Marcobedendo78/Robot-Arduino-4.0/README_PCB.md

# Robot Arduino 4.0 – PCB Personalizzato

Questo progetto include un PCB personalizzato progettato per rendere l’installazione dei moduli, sensori e connessioni più ordinata ed efficiente per un robot tagliaerba basato su Arduino Mega e NodeMCU8266.

---

## 📦 Componenti da assemblare

Componenti


---

## 🧩 Dettaglio PCB principale

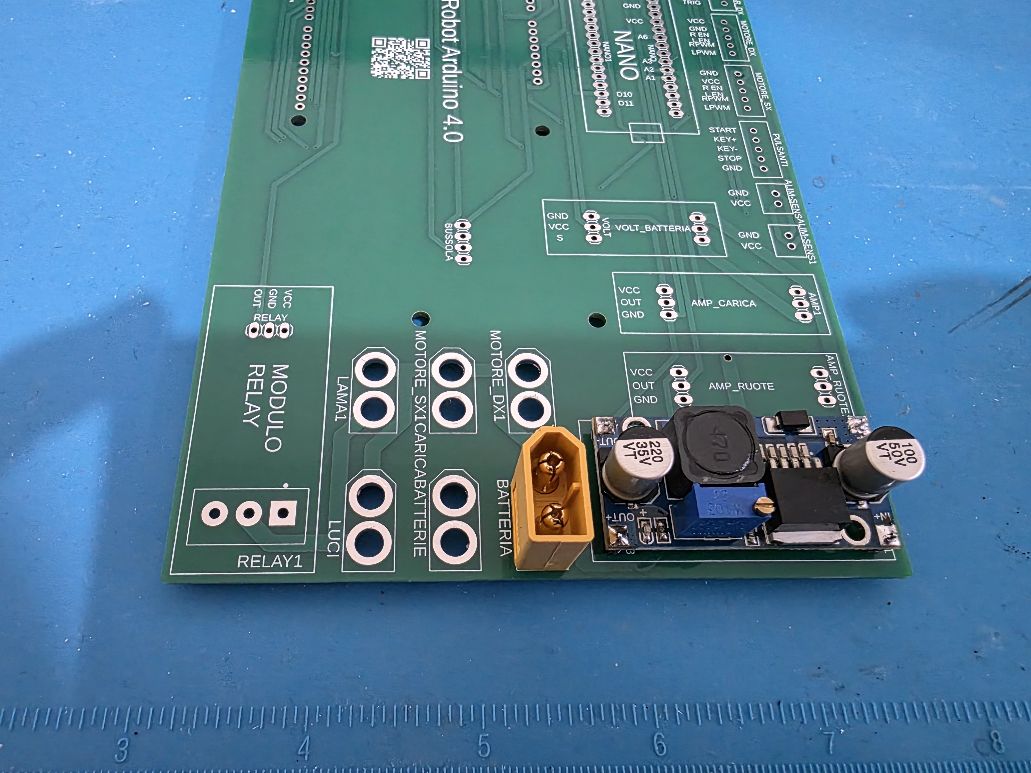
[picture p20: Img/20250508_175606.jpg]
PCB parziale

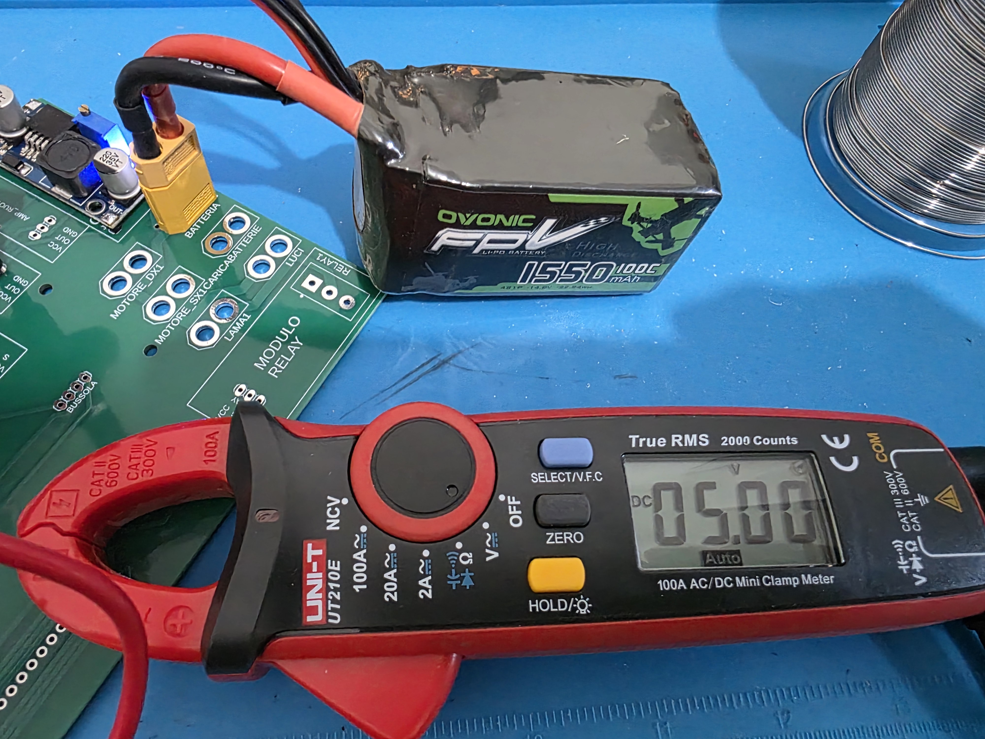
[picture p21: Img/20250508_175658.jpg]
Misurazione 5V


---

## 🔧 PCB Assemblato

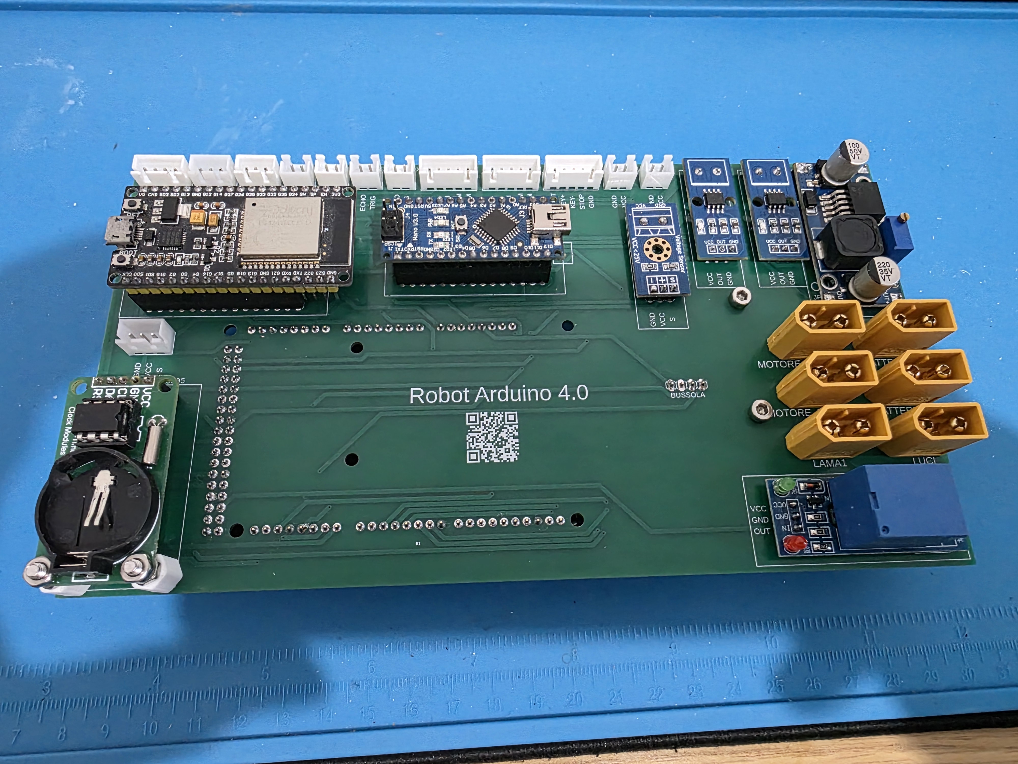
[picture p22: Img/20250508_194420.jpg]
PCB completo

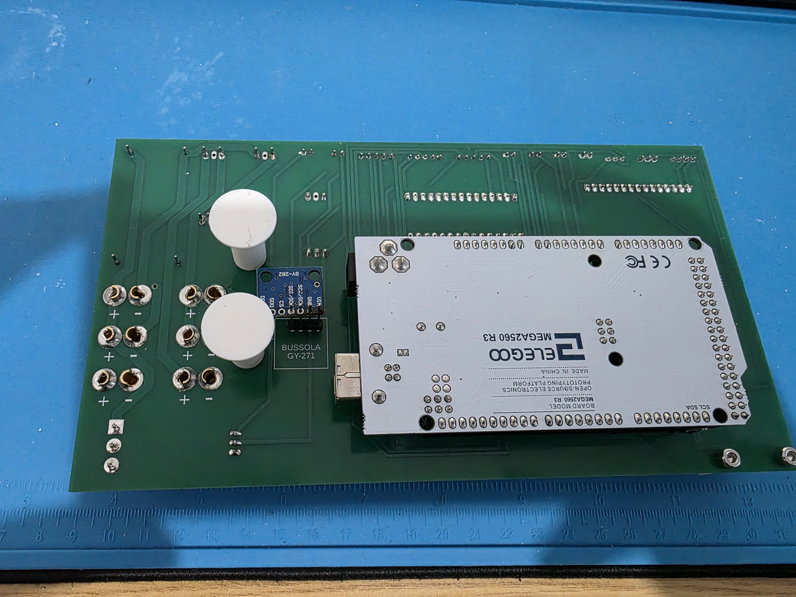
[picture p23: Img/20250508_194433.jpg]
Retro PCB


---

## 🧠 Dettaglio moduli installati

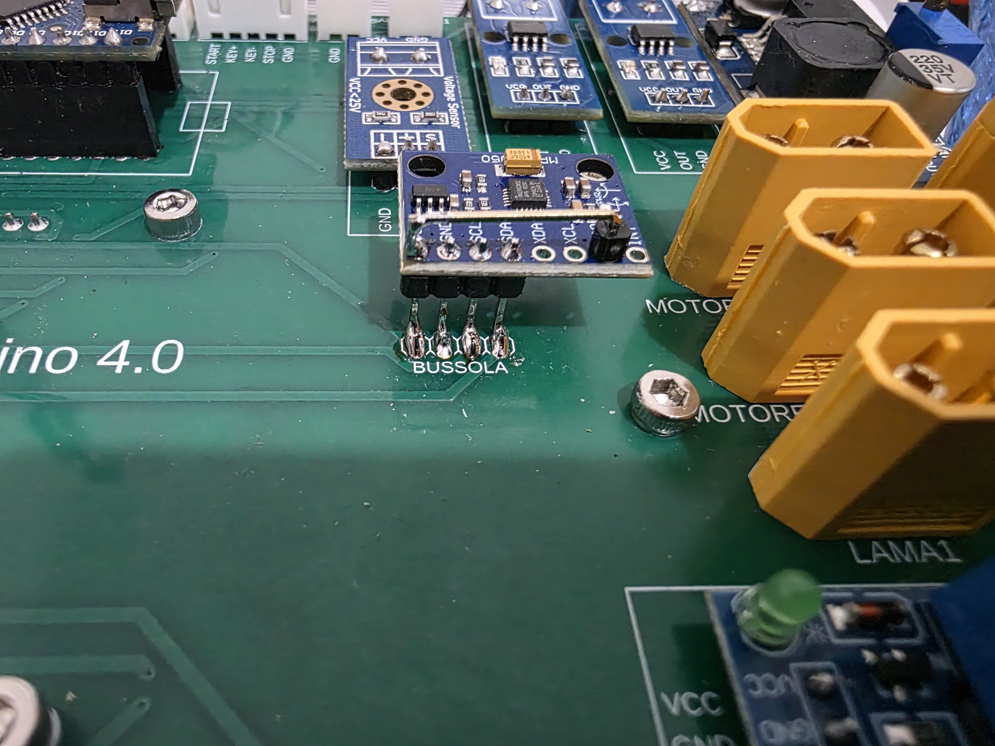
[picture p24: Img/20250530_201129.jpg]
Moduli montati

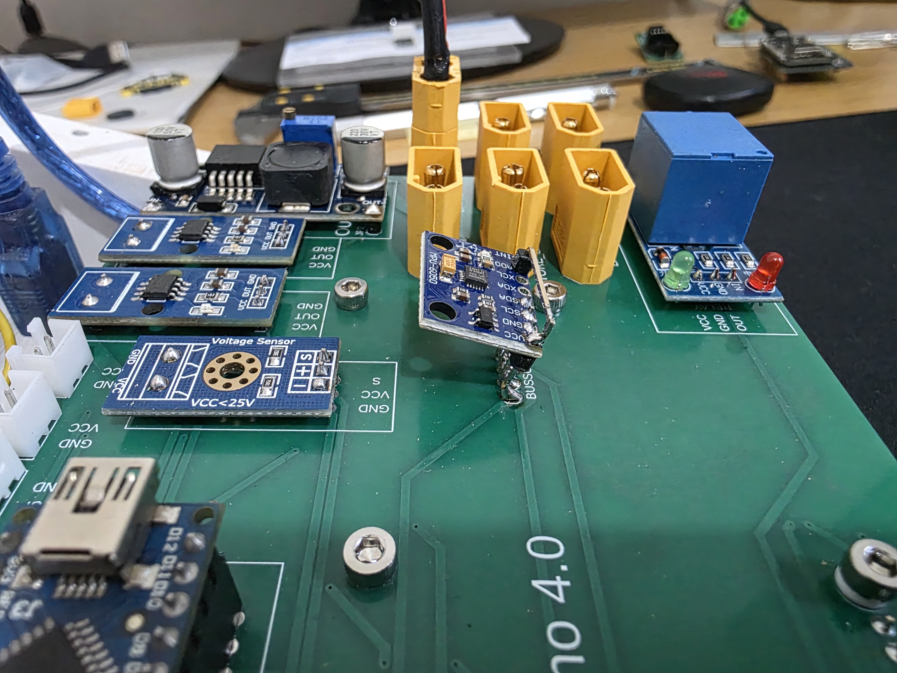
[picture p25: Img/20250531_141824.jpg]
Zoom bussola

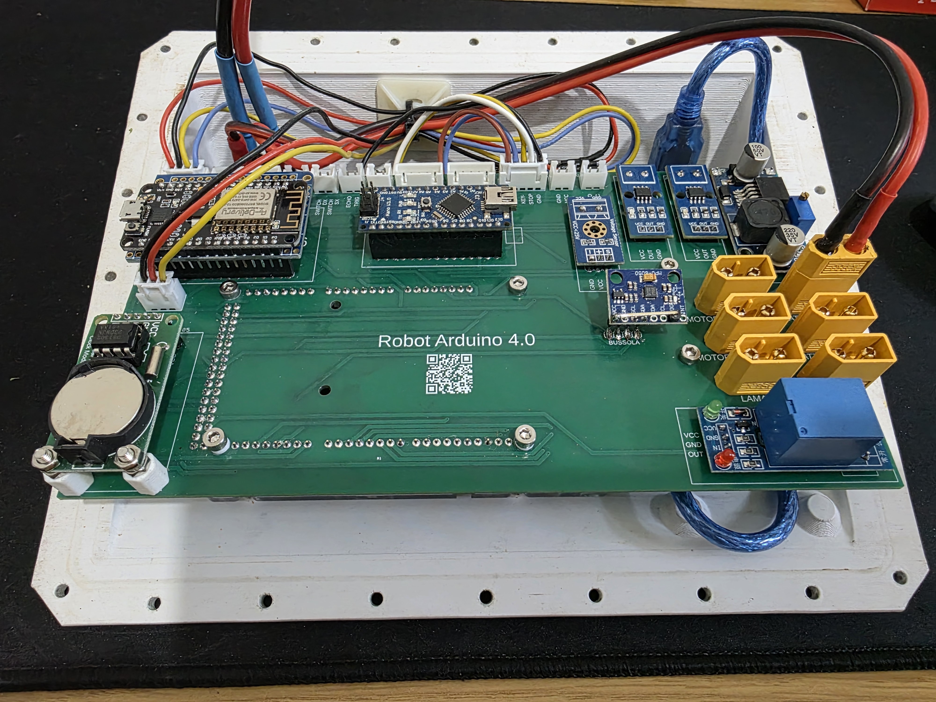
[picture p26: Img/20250531_142255.jpg]
Montaggio inclinato


---

## 🔌 Montaggio nel robot

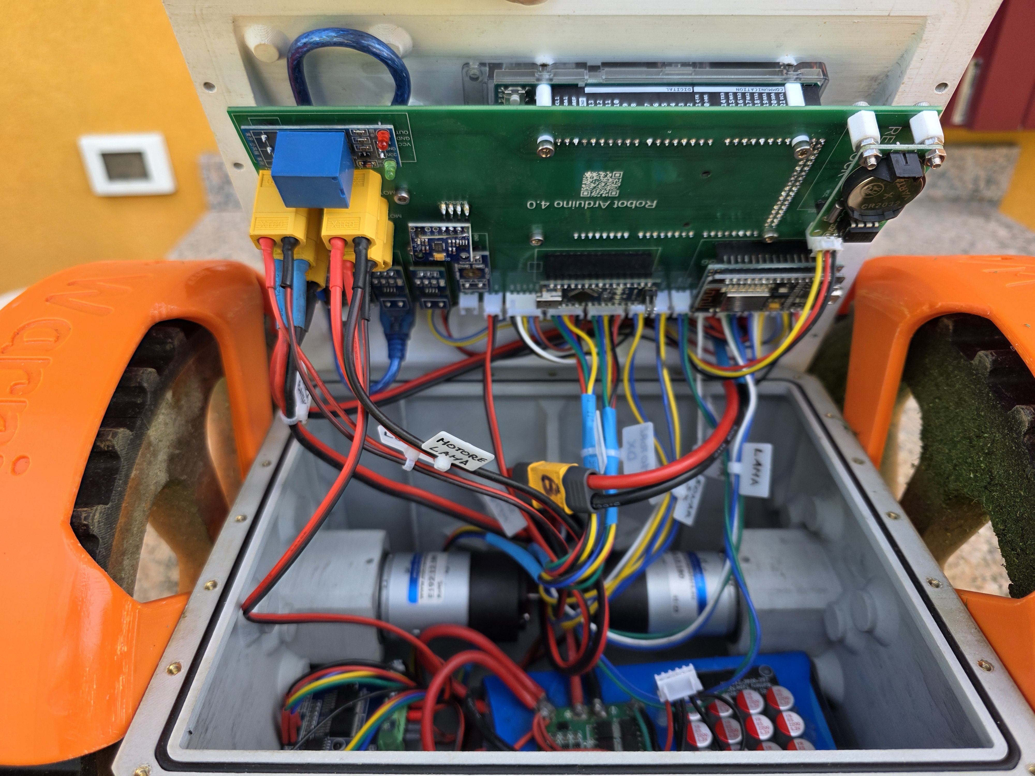
[picture p27: Img/20250531_152122.jpg]
PCB nel robot


---

## 📐 PCB aggiuntivi

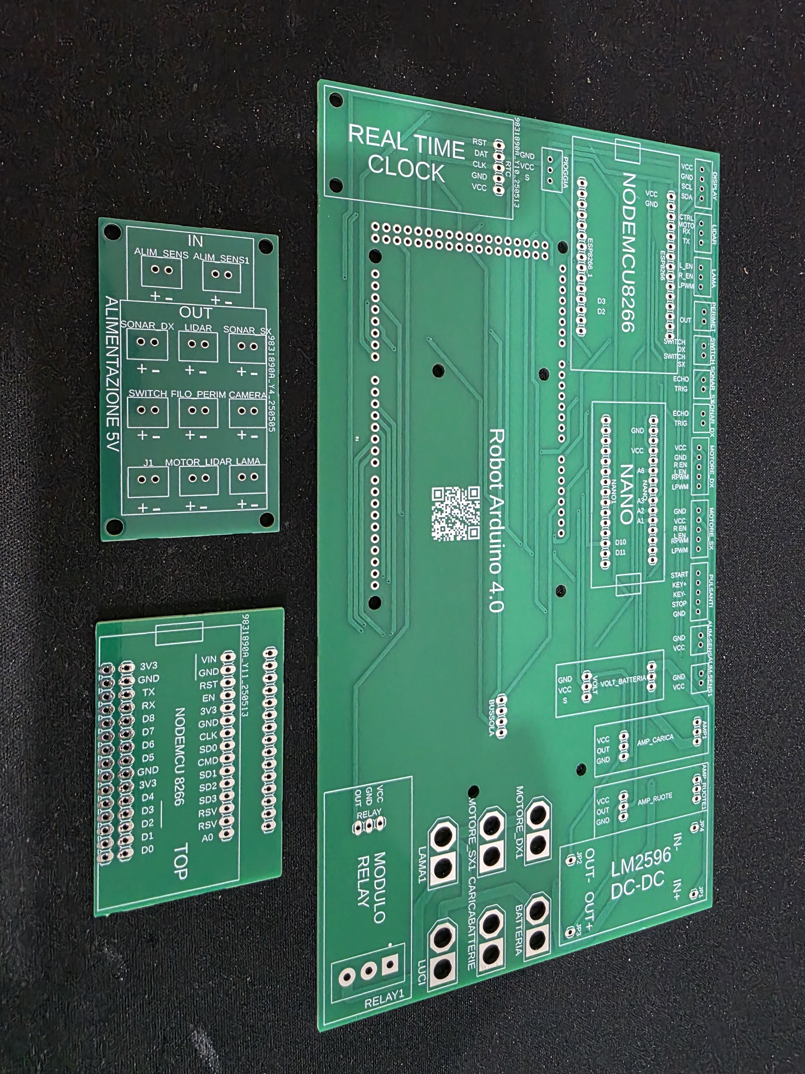
[picture p28: Img/20250602_152717.jpg]
PCB supplementari


---

## ⚡ PCB distribuzione alimentazione 5V

Questo è il piccolo PCB da montare **nella scocca centrale**.  
Serve a **distribuire il 5V e GND** a tutti i sensori frontali, evitando di portare cavi separati da dietro:

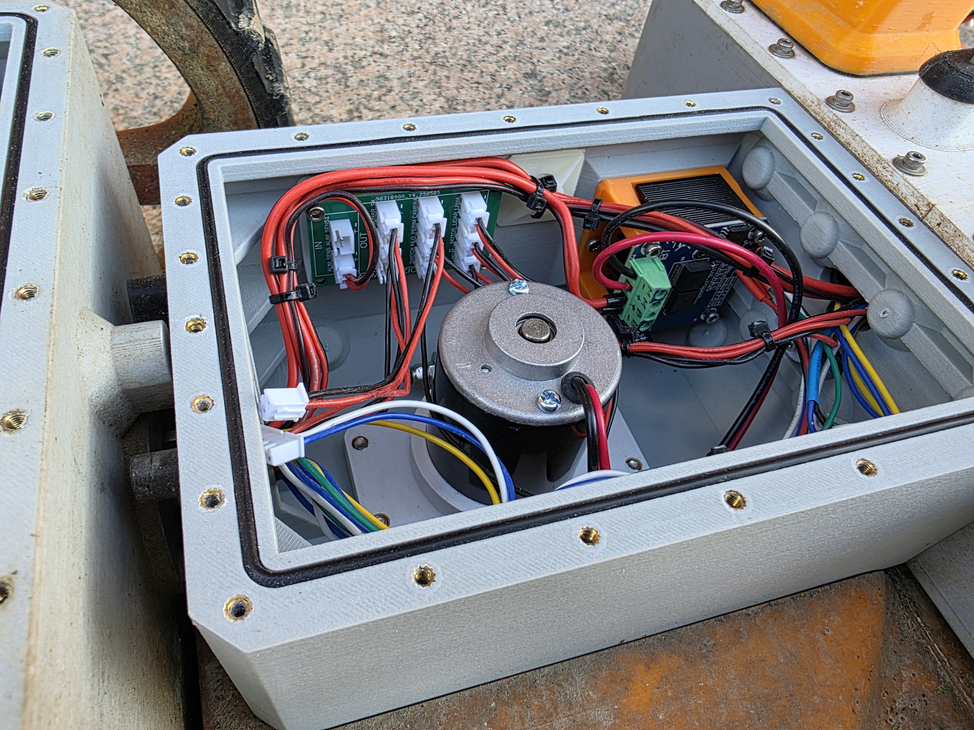
[picture p29: Img/20250517_190916.jpg]
PCB 5V nella scocca


---

## 📃 Descrizione tecnica

Ho creato un PCB da montare sopra Arduino Mega dove installare tutti i connettori dei vari sensori, alimentazione e ricarica della batteria. In questo modo è molto più semplice fare i collegamenti di tutte le parti.

Ho anche creato un PCB da montare nella scocca centrale, che funge da distributore di alimentazione 5V. Questo è pensato per facilitare il cablaggio nel passaggio stretto del foro centrale: così non serve portare GND e 5V per ogni singolo sensore.

Inoltre, ho disegnato un piccolo PCB per adattare i moduli NodeMCU8266 di dimensione più piccola a quello previsto dallo zoccolo della scheda principale.

---

## 🔧 Istruzioni di assemblaggio

1. Dissaldare i pin header e morsetti **originali** dai moduli: sensore tensione, corrente e relay.
2. Saldare nuovi pin header sul lato opposto per montarli direttamente sul PCB.
3. Montare e saldare il modulo **LM2596 step-down** nella sua posizione.
4. Collegare la batteria e **regolare con multimetro** l’uscita a 5.00V precisi.
5. Solo dopo questo step, procedere con la saldatura di tutti gli altri componenti (dal più basso al più alto).
6. Sul lato opposto vanno saldati:
   - i pin header per la bussola **GY-271**
7. Sul lato superiore sui pin della bussola **GY-271** va saldato il modulo **GY-521** (Gyro)

⚠️ **Attenzione**: se non regoli i 5V prima di completare la saldatura, rischi di danneggiare tutti i moduli installati!

---

## 📬 Contatti

Per info o per richiedere i PCB:
👉 Messenger: [Marco Bedendo](https://www.facebook.com/marco.bedendo.54)
