Marcobedendo78/Robot-Arduino-4.0/Mod_brushless_motor/Albero snodo MOD.pdf

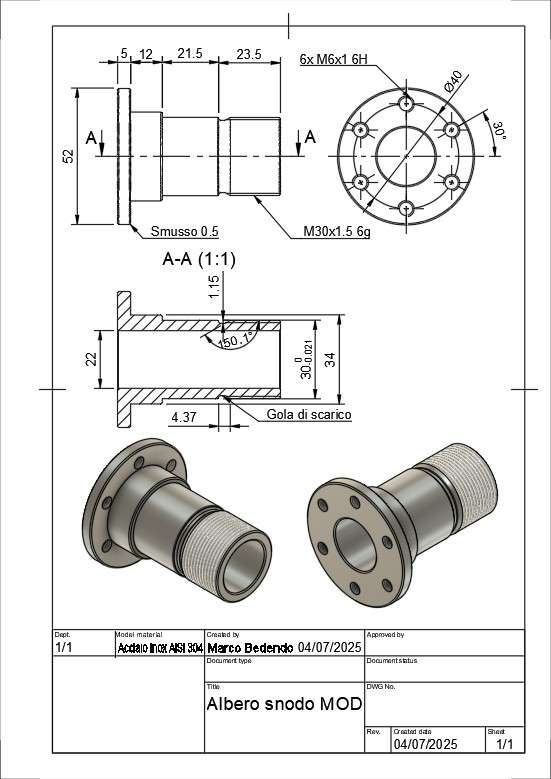
[picture p30: page 1]
