Marcobedendo78/Robot-Arduino-4.0/Upgrade doppi sensori filo e lipo 8s/MEGA_V1_8/Configurazione_Motori.ino

void Motor_Action_Go_Mowing_Speed() {
  
  // No Mag speed adjustment active just go full speed
  if (MAG_Speed_Adjustment == 0) Motor_Action_Go_Full_Speed();  
  
  // Adjust wheel speed according to the MAG level
  if (MAG_Speed_Adjustment == 1) {
          if (MAG_Now >= Slow_Speed_MAG) {
            Motor_Action_Go_Full_Speed(); 
            }
        
          if (MAG_Now < Slow_Speed_MAG)  {
            Motor_Action_Go_Slow_Speed(); 
            }
    }
}

void Motor_Action_Go_Full_Speed()     {
      analogWrite(ENAPin, PWM_MaxSpeed_RH);                          // Velocità = 0-255  (255 è la velocità massima). La velocità è impostata nelle impostazioni
      analogWrite(ENBPin, PWM_MaxSpeed_LH);                          // AnaolgWrite invia segnali PWM Velocità = 0-255  (255 è la velocità massima)
      Serial.print(F("Wheel:FULL|"));
      }  

void Motor_Action_Go_Slow_Speed()     {
      analogWrite(ENAPin,  PWM_Slow_Speed_RH);                       // Velocità = 0-255  (255 è la velocità massima). La velocità è impostata nelle impostazioni                        
      analogWrite(ENBPin,  PWM_Slow_Speed_LH);                       // AnaolgWrite invia segnali PWM Velocità = 0-255  (255 è la velocità massima)
      Serial.print(F("Wheel:SLOW|"));
      }  

void Motor_Action_Max_Slow_Speed()     {
      analogWrite(ENAPin,  PWM_Max_Slow_Speed_RH);                   // Velocità = 0-255  (255 è la velocità massima). La velocità è impostata nelle impostazioni                        
      analogWrite(ENBPin,  PWM_Max_Slow_Speed_LH);                   // AnaolgWrite invia segnali PWM Velocità = 0-255  (255 è la velocità massima)
      Serial.print(F("Wheel:MAX_SLOW|"));
      }

void Motor_Action_Max_Slow_Speed_2()     {
      analogWrite(ENAPin,  PWM_Max_Slow_Speed_2_RH);                  // Velocità = 0-255  (255 è la velocità massima). La velocità è impostata nelle impostazioni                        
      analogWrite(ENBPin,  PWM_Max_Slow_Speed_2_LH);                  // AnaolgWrite invia segnali PWM Velocità = 0-255  (255 è la velocità massima)
      Serial.print(F("Wheel:MAX_SLOW|"));
      }

void Motor_Action_Max_Slow_Speed_3()     {
      analogWrite(ENAPin,  PWM_Max_Slow_Speed_3_RH);                  // Velocità = 0-255  (255 è la velocità massima). La velocità è impostata nelle impostazioni                        
      analogWrite(ENBPin,  PWM_Max_Slow_Speed_3_LH);                  // AnaolgWrite invia segnali PWM Velocità = 0-255  (255 è la velocità massima)
      Serial.print(F("Wheel:MAX_SLOW|"));
      }
      
void Motor_Action_Go_Track_Speed()     {
      analogWrite(ENAPin, PWM_TrackSpeed_RH);                          // Velocità = 0-255  (255 è la velocità massima). La velocità è impostata nelle impostazioni
      analogWrite(ENBPin, PWM_TrackSpeed_LH);                          // AnaolgWrite invia segnali PWM Velocità = 0-255  (255 è la velocità massima)
      Serial.print(F("Wheel:TRACK|"));
      }
   
void Motor_Action_GoFullSpeed_Out_Garage()     {
  //Speeds can be changed to give the mower a slight curve when exiting the Garage.
      analogWrite(ENAPin, PWM_Max_Slow_Speed_RH);                                       // Velocità lenta
      analogWrite(ENBPin, PWM_Max_Slow_Speed_LH);   
      Serial.print(F("Wheel:SLOW|"));
      }

//Rampa di Accelerazione/Crocera/Decelerazione per le inversioni e manovre
void Motor_Action_Go_Accel(unsigned long durataTotale, float percentualeAccel = 0.4, float percentualeDecel = 0.4) {
  // Calcola durata di ciascuna fase
  unsigned long durataAccel = durataTotale * percentualeAccel;
  unsigned long durataDecel = durataTotale * percentualeDecel;
  unsigned long durataCrociera = durataTotale - durataAccel - durataDecel;

  int stepsAccel = max(PWM_Max_Slow_Speed_2_RH, PWM_Max_Slow_Speed_2_LH);
  int stepsDecel = stepsAccel;
  unsigned long delayPerStepAccel = durataAccel / stepsAccel;
  unsigned long delayPerStepDecel = durataDecel / stepsDecel;

  // Accelerazione
  for (int i = 0; i <= stepsAccel; i++) {
    int currentRH = min(i, PWM_Max_Slow_Speed_2_RH);
    int currentLH = min(i, PWM_Max_Slow_Speed_2_LH);
    analogWrite(ENAPin, currentRH);
    analogWrite(ENBPin, currentLH);
    delay(delayPerStepAccel);
  }

  // Crociera
  analogWrite(ENAPin, PWM_Max_Slow_Speed_2_RH);
  analogWrite(ENBPin, PWM_Max_Slow_Speed_2_LH);
  delay(durataCrociera);

  // Decelerazione
  for (int i = stepsDecel; i >= 0; i--) {
    int currentRH = min(i, PWM_Max_Slow_Speed_2_RH);
    int currentLH = min(i, PWM_Max_Slow_Speed_2_LH);
    analogWrite(ENAPin, currentRH);
    analogWrite(ENBPin, currentLH);
    delay(delayPerStepDecel);
  }
}


// Rampa dolce fino alla velocità di taglio (una sola volta a inizio ciclo)
static bool      g_softStartActive = false;
static uint32_t  g_softStartT0     = 0;
static uint32_t  g_softStartDur    = 0;
static uint8_t   g_targetRH        = 0;
static uint8_t   g_targetLH        = 0;

void Motor_Action_SoftStart_To_Mow(unsigned long durata_ms) {
  // Avvio rampa (prima chiamata)
  if (!g_softStartActive) {
    g_targetRH = PWM_MaxSpeed_RH;
    g_targetLH = PWM_MaxSpeed_LH;

    if (durata_ms == 0 || (g_targetRH == 0 && g_targetLH == 0)) {
      analogWrite(ENAPin, g_targetRH);
      analogWrite(ENBPin, g_targetLH);
      return;
    }
    g_softStartActive = true;
    g_softStartT0     = millis();
    g_softStartDur    = durata_ms;

    analogWrite(ENAPin, 0);
    analogWrite(ENBPin, 0);
    Serial.print(F("Wheel:SOFT_START_BEGIN|"));
    return; // inizializzato; gli step li facciamo nelle chiamate successive
  }

  // Aggiornamento rampa
  uint32_t elapsed = millis() - g_softStartT0;

  // clamp a fine rampa: imposta direttamente i target e chiudi
  if (elapsed >= g_softStartDur) {
    analogWrite(ENAPin, g_targetRH);
    analogWrite(ENBPin, g_targetLH);
    g_softStartActive = false;
    Serial.print(F("Wheel:SOFT_START_END|"));
    return;
  }

  uint8_t currRH, currLH;

#if SOFTSTART_EASE_QUAD
  // Easing "ease-in" quadratico con interi:
  // progress = (elapsed/dur)^2  -> PWM = target * progress
  // Usiamo 64 bit per evitare overflow in elapsed*elapsed
  uint64_t e  = (uint64_t)elapsed;
  uint64_t d  = (uint64_t)g_softStartDur;
  uint64_t pN = e * e;      // numeratore progress
  uint64_t pD = d * d;      // denominatore progress
  currRH = (uint8_t)(( (uint64_t)g_targetRH * pN ) / pD);
  currLH = (uint8_t)(( (uint64_t)g_targetLH * pN ) / pD);
#else
  // Lineare puro con soli 32 bit:
  // PWM = target * elapsed / durata
  currRH = (uint8_t)(((uint32_t)g_targetRH * elapsed) / g_softStartDur);
  currLH = (uint8_t)(((uint32_t)g_targetLH * elapsed) / g_softStartDur);
#endif

  analogWrite(ENAPin, currRH);
  analogWrite(ENBPin, currLH);
}

bool Motor_Action_SoftStart_IsActive() { return g_softStartActive; }

//Rampa di accelerazione per le rotazioni
void Motor_Action_Go_Accel_Turn() {
 for (int i = 0; i < 255; i++) {
    analogWrite(ENAPin, i);
    analogWrite(ENBPin, i);
    delay(2);  // Durata di ogni step
  }
}

// Utilizzato per far girare il tosaerba a una velocità impostata. o ridotta o con rampa di accelerazione
void Motor_Action_Turn_Speed() {
     if (Accel_Speed_Adjustment == 0) {
       analogWrite(ENAPin, (PWM_MaxSpeed_RH - Turn_Adjust));
       analogWrite(ENBPin, (PWM_MaxSpeed_LH - Turn_Adjust));
     }
     else if (Accel_Speed_Adjustment == 1) {
       Motor_Action_Go_Accel_Turn();
     }
   }


void SetPins_ToGoForwards()     {                                     // I pin del driver motore sono impostati per consentire a entrambi i motori di spostarsi in avanti.
  digitalWrite(IN1Pin, LOW);                                          // I pin del driver motore sono impostati su alto o basso per impostare la direzione del movimento
  digitalWrite(IN2Pin, HIGH);
  digitalWrite(IN3Pin, LOW);
  digitalWrite(IN4Pin, HIGH);
  Serial.print(F("Wheel:For|"));
  }


void SetPins_ToGoBackwards()      {                               // I pin del driver motore sono impostati per consentire a entrambi i motori di spostarsi indietro.
  digitalWrite(IN1Pin, HIGH);                                     // Motor 1
  digitalWrite(IN2Pin, LOW);
  digitalWrite(IN3Pin, HIGH);                                     // Motor 2
  digitalWrite(IN4Pin, LOW);
  Serial.print(F("Wheel:Rev|"));
  delay(20);
  }


void Motor_Action_Stop_Motors()  {                                 // I pin del driver motore sono impostati per consentire a entrambi i motori di stopparsi.
  digitalWrite(ENAPin, 0);                                         //Motor 1
  digitalWrite(IN1Pin, LOW);
  digitalWrite(IN2Pin, LOW);
  digitalWrite(ENBPin, 0);                                         //Motor 2
  digitalWrite(IN3Pin, LOW);
  digitalWrite(IN4Pin, LOW);
  Serial.print(F("Wheel:0FF|"));
}


void SetPins_ToTurnLeft()       {                                  // I pin sono impostati in modo che i motori girino in direzioni opposte
    digitalWrite(IN1Pin, LOW);                                     // Motor 1
    digitalWrite(IN2Pin, HIGH);
    digitalWrite(IN3Pin, HIGH);                                    // Motor 2
    digitalWrite(IN4Pin, LOW);
    Serial.print(F("Wheel:TL_|"));  
    }


void SetPins_ToTurnRight() {                                       // I pin sono impostati in modo che i motori girino in direzioni opposte
      digitalWrite(IN1Pin, HIGH);                                  // Motor 1
      digitalWrite(IN2Pin, LOW);
      digitalWrite(IN3Pin, LOW);                                   //Motor 2
      digitalWrite(IN4Pin, HIGH);
      Serial.print(F("Wheel:R|"));
      }



// Accende il motore taglio erba
void Motor_Action_Spin_Blades() {
  if (Cutting_Blades_Activate == 1) {
    delay(20);
    
    #if USE_DRIVER_BTS7960
      digitalWrite(R_EN, HIGH);      // Enable right
      digitalWrite(L_EN, HIGH);      // Enable left
    #elif USE_DRIVER_ZS_X11H
      digitalWrite(R_EN, HIGH);      // DIR = forward (LOW se vuoi reverse)
      delay(10);
      digitalWrite(L_EN, HIGH);      // STOP = HIGH → abilita driver
      delay(5);
    #endif

    delay(20);
    analogWrite(RPWM, PWM_Blade_Speed);
    delay(20);
    Serial.print(F("Blades:ON_|"));
  }

  if (Cutting_Blades_Activate == 0) {
    Motor_Action_Stop_Spin_Blades();
  }
}



// Spegne il motore taglio erba
void Motor_Action_Stop_Spin_Blades() {
  delay(20);

  #if USE_DRIVER_BTS7960
    digitalWrite(R_EN, LOW);       // Disabilita
    digitalWrite(L_EN, LOW);
  #elif USE_DRIVER_ZS_X11H
    analogWrite(RPWM, 0);          // Ferma motore
    digitalWrite(L_EN, LOW);       // STOP attivo (LOW) → driver disabilitato
  #endif

  delay(20);
  Serial.print(F("Blades:OFF|"));
}


//Sterza il tosaerba in base all'ingresso PID dell'algoritmo
void Motor_Action_Dynamic_PWM_Steering() {
      analogWrite(ENAPin, PWM_Right);                             // ENA low = Sterzata a destra   ENB low = Sterzata a sinistra
      analogWrite(ENBPin, PWM_Left);
      Serial.print(F("PWM_R:"));
      Serial.print(PWM_Right);
      Serial.print(F("|"));
      Serial.print(F("PWM_L:"));
      Serial.print(PWM_Left);
      Serial.print(F("|"));
}

int targetHeading = 9000;  // 90.00 gradi scalato x100

// === PID BASATO SUL GYRO ===
void Controllo_PID_Gyro(int headingAttuale) {
  static long pid_error = 0, pid_lastError = 0, pid_integral = 0, pid_derivative = 0;

  // Base di velocità
  int baseSpeed_L = PWM_MaxSpeed_LH;  
  int baseSpeed_R = PWM_MaxSpeed_RH;

  // Errore tra heading attuale e target, tenendo conto del ciclo 0-36000
  pid_error = headingAttuale - targetHeading;
  if (pid_error > 18000) pid_error -= 36000;
  if (pid_error < -18000) pid_error += 36000;

  pid_integral += pid_error;
  pid_derivative = pid_error - pid_lastError;
  pid_lastError = pid_error;

  // PID intero (Kp,Ki,Kd sono in centesimi, quindi dividiamo il totale per 100)
  long correzione = (Kp * pid_error + Ki * pid_integral + Kd * pid_derivative) / 100;

  // Applica correzione alle due ruote
  int pwmLeft  = constrain(baseSpeed_L - correzione, 0, PWM_MaxSpeed_LH);
  int pwmRight = constrain(baseSpeed_R + correzione, 0, PWM_MaxSpeed_RH);

  analogWrite(ENAPin, pwmRight);         // DX
  analogWrite(ENBPin, pwmLeft);          // SX

  Serial.print(F("PID|H:"));
  Serial.print(headingAttuale / 100.0);  // stampa in gradi reali
  Serial.print(F("|Err:"));
  Serial.println(pid_error / 100.0);     // errore in gradi
}
