Marcobedendo78/Robot-Arduino-4.0/Upgrade doppi sensori filo e lipo 8s/MEGA_V1_8/Menu_Sensori.ino

// SENSORS SETTINGS MENU


// Test to displyed on the LCD screen when using the membrane key menus
void Print_LCD_Menu_Sensors(byte LCD_Menu_Sensors) {
  if (LCD_Menu_Sensors == 1)  lcd.print(F("SONAR ON/OFF"));
  if (LCD_Menu_Sensors == 2)  lcd.print(F("Distanza SONAR"));
  if (LCD_Menu_Sensors == 3)  lcd.print(F("Sensib. SONAR"));   
  if (LCD_Menu_Sensors == 4)  lcd.print(F("Batteria Min/Max"));
  if (LCD_Menu_Sensors == 5)  lcd.print(F("Batt Sensibilità"));
  if (LCD_Menu_Sensors == 6)  lcd.print(F("FILO ON/OFF"));   
  if (LCD_Menu_Sensors == 7)  lcd.print(F("PIOGGIA ON/OFF"));
  if (LCD_Menu_Sensors == 8)  lcd.print(F("Sensib. PIOGGIA"));
  if (LCD_Menu_Sensors == 9)  lcd.print(F("WIFI ON/OFF"));
  if (LCD_Menu_Sensors == 10) lcd.print(F("PARAURTI ON/OFF"));
  if (LCD_Menu_Sensors == 11) lcd.print(F("RPLidar ON/OFF"));
  if (LCD_Menu_Sensors == 12)  lcd.print(F("Distanza LIDAR"));
  
  Max_Options_Sensors = 12;
  }


void Print_Membrane_Switch_Input_Sensors() {
     Read_Membrane_Keys();
     Menu_Complete = 1;
     Menu_Mode_Selection = 0;
     Menu_View = 0;

      Serial.println();
      Serial.println(F("Sensors Menu Activated"));
      Menu_Complete_Sensors = false;                                // Menu complete will return to the normal loop
      lcd.clear();
      delay(5);
      
      while (Menu_Complete_Sensors == false) {                      // holds the program in a loop until a selection has been made in the membrane button menu
        if (Menu_View == 0) {
          lcd.setCursor(1,0);
          Print_LCD_Menu_Sensors(1);
          lcd.setCursor(1,1);
          Print_LCD_Menu_Sensors(2);
          }
        // Gets the values again from the keys
        Read_Membrane_Keys();
        delay(100);
             
        if(!Start_Key_X){
          Menu_Complete_Sensors = true;
          Serial.println(F("Start key is pressed"));
          Activate_Menu_Option_Sensors();
          lcd.clear();
          
          }
        if(!Plus_Key_X) {
          Serial.println(F("+ key is pressed"));
          Menu_View = Menu_View - 1;
          Run_Menu_Order_Sensors();
          }
        if(!Minus_Key_X) {
          Menu_View = Menu_View + 1;
          Run_Menu_Order_Sensors();
        }
        if(!Stop_Key_X){
          Serial.println(F("Stop key is pressed"));
          Menu_Complete_Sensors = true;
          lcd.clear();
          lcd.setCursor(0,0);
          lcd.print("Uscita Sensori");
          delay(1000);
          lcd.clear();          
          Menu_Mode_Selection = 0;
          }
      }
    }

    


// Code to scroll the menu and print the menu options in the LCD
 void Run_Menu_Order_Sensors() {
     if (Menu_View > Max_Options_Sensors) Menu_View = Menu_View -1;
     if (Menu_View < 0) Menu_View = Menu_View + 1;      
     Serial.print(F("- key is pressed "));
     lcd.clear();
     lcd.setCursor(1,0);
     Print_LCD_Menu_Sensors(Menu_View);
     lcd.setCursor(1,1);
     Print_LCD_Menu_Sensors(Menu_View + 1);
     lcd.setCursor(0,0);
     lcd.print(">");
     Menu_Mode_Selection = Menu_View;
     Serial.print(F("Menu View : "));
     Serial.print(Menu_View);
     Serial.print(F("| Menu Selection"));
     Serial.println(Menu_Mode_Selection);
     delay(100);
     }

     
// Defines the actions when that option is selected with the keypad.
void Activate_Menu_Option_Sensors() {

     if (Menu_Mode_Selection == 1) {
       // SONAR ON/OFF
     
       int Set = 1;
       Menu_Mode_Selection = 0;
       lcd.clear();
       delay(100);
       lcd.setCursor(0,0);
       lcd.print(F("Attiva SONAR Y/N"));
       lcd.setCursor(0,1);
       lcd.print(F(">S2:"));
       if (Sonar_2_Activate == 1) lcd.print("Y");
       if (Sonar_2_Activate == 0) lcd.print("N");
       lcd.print(F(" S1:"));
       if (Sonar_1_Activate == 1) lcd.print("Y");
       if (Sonar_1_Activate == 0) lcd.print("N");
       lcd.print(F(" S3:"));
       if (Sonar_3_Activate == 1) lcd.print("Y");
       if (Sonar_3_Activate == 0) lcd.print("N");
       delay(2000);

       Menu_Complete_Sensors = false;
       while (Menu_Complete_Sensors == false) {
             Read_Membrane_Keys();
             delay(100);
             //Enter Code Here to Cycle until stop key is pressed.
             if(!Start_Key_X){
             
             if (Set == 3) {
               lcd.clear(); 
               lcd.setCursor(0,0);
               lcd.print(F("SONAR"));
               lcd.setCursor(0,1);
               lcd.print(F("Salva Settaggio"));
               delay(2000);            
               EEPROM.write(37, 1);
               EEPROM.write(38, Sonar_1_Activate);
               EEPROM.write(39, 1);
               EEPROM.write(40, Sonar_2_Activate);
               EEPROM.write(41, 1);
               EEPROM.write(42, Sonar_3_Activate);
               Menu_Mode_Selection = 0;
               Menu_Complete_Sensors = true;
               }

             
             if (Set == 2) { 
                lcd.clear();
                lcd.setCursor(0,0);
                lcd.print(F("S = Si  N = No"));
                lcd.setCursor(0,1);
                lcd.print(F(" S2:"));
                if (Sonar_2_Activate == 1) lcd.print("S");
                if (Sonar_2_Activate == 0) lcd.print("N");
                lcd.print(F(" S1:"));
                if (Sonar_1_Activate == 1) lcd.print("S");
                if (Sonar_1_Activate == 0) lcd.print("N");
                lcd.print(F(">S3:"));
                if (Sonar_3_Activate == 1) lcd.print("S");
                if (Sonar_3_Activate == 0) lcd.print("N");
                Set = Set + 1;         
               }
            
             if (Set == 1) { 
                lcd.clear();
                lcd.setCursor(0,0);
                lcd.print(F("S = Si  N = No"));
                lcd.setCursor(0,1);
                lcd.print(F(" S2:"));
                if (Sonar_2_Activate == 1) lcd.print("S");
                if (Sonar_2_Activate == 0) lcd.print("N");
                lcd.print(F(">S1:"));
                if (Sonar_1_Activate == 1) lcd.print("S");
                if (Sonar_1_Activate == 0) lcd.print("N");
                lcd.print(F(" S3:"));
                if (Sonar_3_Activate == 1) lcd.print("S");
                if (Sonar_3_Activate == 0) lcd.print("N");
                Set = Set + 1;         
               }
             }

             if (!Plus_Key_X) {
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
                 lcd.print(F("S = Si  N = No"));
                 lcd.setCursor(0,1);
                 lcd.print(F(" S2:"));
                 if (Sonar_2_Activate == 1) lcd.print("S");
                 if (Sonar_2_Activate == 0) lcd.print("N");
                 lcd.print(F(" S1:"));
                 if (Sonar_1_Activate == 1) lcd.print("S");
                 if (Sonar_1_Activate == 0) lcd.print("N");
                 lcd.print(F(">S3:"));
                 if (Sonar_3_Activate == 1) lcd.print("S");
                 if (Sonar_3_Activate == 0) lcd.print("N");
               }         
           }
     }
     }

     if (Menu_Mode_Selection == 2) {
       // SONAR Distance
       Menu_Mode_Selection = 0;
       lcd.clear();
       delay(500);
       lcd.setCursor(0,0);
       lcd.print(F("Distanza Sonar:"));
       lcd.setCursor(0,1);
       lcd.print(F("Cm = "));
       lcd.print(maxdistancesonar);
       Serial.print(F("Sonar Distnace = :"));
       Serial.println(maxdistancesonar);
       Menu_Complete_Sensors = false;
       while (Menu_Complete_Sensors == false) {
             Read_Membrane_Keys();
             delay(100);
             //Enter Code Here to Cycle until stop key is pressed.
             if(!Start_Key_X){
             Serial.println(F("Settings Saved"));
             Menu_Complete_Sensors = true;
             lcd.clear();
             lcd.setCursor(0,0);
             lcd.print(F("Cm = "));
             lcd.print(maxdistancesonar);
             lcd.setCursor(0,1);
             lcd.print(F("SALVATO"));
             delay(2000);
             lcd.clear();          
             EEPROM.write(65, 1);
             EEPROM.write(66, maxdistancesonar);   
             Menu_Mode_Selection = 0;
             }
             if (!Plus_Key_X) {
               maxdistancesonar = maxdistancesonar + 1;
               if (maxdistancesonar> 100) maxdistancesonar = 100;
               lcd.clear();
               lcd.setCursor(0,0);
               lcd.print(F("Distanza Sonar:"));
               lcd.setCursor(0,1);
               lcd.print(F("Cm = "));
               lcd.print(maxdistancesonar);
               Serial.print(F("Distan Sonar = :"));
               Serial.println(maxdistancesonar);
               }
             if (!Minus_Key_X) {
               maxdistancesonar = maxdistancesonar - 1;
               if (maxdistancesonar < 10) maxdistancesonar = 10;
               lcd.clear();
               lcd.setCursor(0,0);
               lcd.print(F("Distanza Sonar:"));
               lcd.setCursor(0,1);
               lcd.print(F("Cm = "));
               lcd.print(maxdistancesonar);
               Serial.print(F("Distan Sonar = :"));
               Serial.println(maxdistancesonar);
               }
             
             }
     }



     if (Menu_Mode_Selection == 3) {
       // SONAR Sensitivity
       Menu_Mode_Selection = 0;
       lcd.clear();
       delay(500);
       lcd.setCursor(0,0);
       lcd.print(F("Sensib. Sonar:"));
       lcd.setCursor(0,1);
       lcd.print(F("Hits = "));
       lcd.print(Max_Sonar_Hit);
       Serial.print(F("Sensib Sonar = :"));
       Serial.println(Max_Sonar_Hit);
       Menu_Complete_Sensors = false;
       while (Menu_Complete_Sensors == false) {
             Read_Membrane_Keys();
             delay(100);
             //Enter Code Here to Cycle until stop key is pressed.
             if(!Start_Key_X){
             Serial.println(F("Settings Saved"));
             Menu_Complete_Sensors = true;
             lcd.clear();
             lcd.setCursor(0,0);
             lcd.print("Hits : ");
             lcd.print(Max_Sonar_Hit);
             lcd.setCursor(0,1);
             lcd.print(F("SALVATO"));
             delay(2000);
             lcd.clear();          
             EEPROM.write(63, 1);
             EEPROM.write(64, Max_Sonar_Hit);   
             Menu_Mode_Selection = 0;
             }
             if (!Plus_Key_X) {
               Max_Sonar_Hit = Max_Sonar_Hit + 1;
               if (Max_Sonar_Hit> 10) Max_Sonar_Hit = 10;
               lcd.clear();
               lcd.setCursor(0,0); 
               lcd.print(F("Sensib. Sonar:"));
               lcd.setCursor(0,1);
               lcd.print(F("Hits = "));
               lcd.print(Max_Sonar_Hit);
               Serial.print(F("Sensib Sonar = :"));
               Serial.println(Max_Sonar_Hit);
               }
             if (!Minus_Key_X) {
               Max_Sonar_Hit = Max_Sonar_Hit - 1;
               if (Max_Sonar_Hit < 1) Max_Sonar_Hit = 1;
               lcd.clear();
               lcd.setCursor(0,0); 
               lcd.print(F("Sensib. Sonar:"));
               lcd.setCursor(0,1);
               lcd.print(F("Hits = "));
               lcd.print(Max_Sonar_Hit);
               Serial.print(F("Sonar sensitivity = :"));
               Serial.println(Max_Sonar_Hit);
               }
             
             }
     }


     if (Menu_Mode_Selection == 4) {
       // Battery Min Setting
       Menu_Mode_Selection = 0;
       lcd.clear();
       delay(500);
       lcd.setCursor(0,0);
       lcd.print("Volt Batteria Min");
       lcd.setCursor(0,1);
       lcd.print("V = ");
       lcd.print(Battery_Min, 1);
       Serial.print(F("Battery Minimum Volt = :"));
       Serial.println(Battery_Min, 1);
       Menu_Complete_Sensors = false;

       while (Menu_Complete_Sensors == false) {
             Read_Membrane_Keys();
             delay(100);

             // Salva e chiudi (Start premuto)
             if (!Start_Key_X) {
               Serial.println(F("Settings Saved"));
               Menu_Complete_Sensors = true;
               lcd.clear();
               lcd.setCursor(0,0);
               lcd.print("V = ");
               lcd.print(Battery_Min, 1);
               lcd.setCursor(0,1);
               lcd.print("SALVATO");
               delay(2000);
               lcd.clear();

               EEPROM.write(25, 1);                                 // flag invariato
               int valueToSave = (int)(Battery_Min * 10.0 + 0.5);   // es. 33.6 -> 336
               EEPROM.put(100, valueToSave);                        // salva su 100-101


               Menu_Mode_Selection = 0;
             }

             // Incrementa di 0.1V (Plus premuto)
             if (!Plus_Key_X) {
               Battery_Min = Battery_Min + 0.1f;
               if (Battery_Min > Battery_Max) Battery_Min = Battery_Max;
               // forza arrotondamento al decimo per evitare errori float
               Battery_Min = ((int)(Battery_Min * 10.0 + 0.5)) / 10.0;

               lcd.setCursor(0,1);
               lcd.print("            "); // pulizia riga
               lcd.setCursor(0,1);
               lcd.print("V = ");
               lcd.print(Battery_Min, 1);
               Serial.print(F("Minimum Battery Voltage = :"));
               Serial.println(Battery_Min, 1);
             }

             // Decrementa di 0.1V (Minus premuto)
             if (!Minus_Key_X) {
               Battery_Min = Battery_Min - 0.1f;
               if (Battery_Min < Battery_Nomin) Battery_Min = Battery_Nomin;
               // forza arrotondamento al decimo
               Battery_Min = ((int)(Battery_Min * 10.0 + 0.5)) / 10.0;

               lcd.setCursor(0,1);
               lcd.print("            "); // pulizia riga
               lcd.setCursor(0,1);
               lcd.print("V = ");
               lcd.print(Battery_Min, 1);
               Serial.print(F("Minimum Battery Voltage = :"));
               Serial.println(Battery_Min, 1);
             }
         }
     }


     if (Menu_Mode_Selection == 5) {
       // Battery to Charge Sensitivity
       Menu_Mode_Selection = 0;
       delay(500);
       lcd.clear();
       lcd.setCursor(0,0);
       lcd.print(F("Sensibilità Batt"));
       lcd.setCursor(0,1);
       lcd.print(F("Hits = "));
       lcd.print(Low_Battery_Instances_Chg);
       Serial.print(F("Sensib Batt = :"));
       Serial.println(Low_Battery_Instances_Chg);
       Menu_Complete_Sensors = false;
       while (Menu_Complete_Sensors == false) {
             Read_Membrane_Keys();
             delay(100);
             //Enter Code Here to Cycle until stop key is pressed.
             if(!Start_Key_X){
             Serial.println(F("Settings Saved"));
             Menu_Complete_Sensors = true;
             lcd.clear();
             lcd.setCursor(0,0);
             lcd.print("Hits : ");
             lcd.print(Low_Battery_Instances_Chg);
             lcd.setCursor(0,1);
             lcd.print(F("SALVATO"));
             delay(2000);
             lcd.clear();          
             EEPROM.write(85, 1);
             EEPROM.write(86, Low_Battery_Instances_Chg);   
             Menu_Mode_Selection = 0;
             }
             if (!Plus_Key_X) {
               Low_Battery_Instances_Chg = Low_Battery_Instances_Chg + 1;
               if (Low_Battery_Instances_Chg> 50) Low_Battery_Instances_Chg = 50;
               lcd.clear();
               lcd.setCursor(0,0); 
               lcd.print(F("Sensibilità Batt"));
               lcd.setCursor(0,1);
               lcd.print(F("Hits = "));
               lcd.print(Low_Battery_Instances_Chg);
               Serial.print(F("Battery sensitivity = :"));
               Serial.println(Low_Battery_Instances_Chg);
               }
             if (!Minus_Key_X) {
               Low_Battery_Instances_Chg = Low_Battery_Instances_Chg - 1;
               if (Low_Battery_Instances_Chg < 1) Low_Battery_Instances_Chg = 1;
               lcd.clear();
               lcd.setCursor(0,0); 
               lcd.print(F("Sensibilità Batt"));
               lcd.setCursor(0,1);
               lcd.print(F("Hits = "));
               lcd.print(Low_Battery_Instances_Chg);
               Serial.print(F("Battery sensitivity = :"));
               Serial.println(Low_Battery_Instances_Chg);
               }
             
             }
     }



   if (Menu_Mode_Selection == 6) {
       // Wire Sensor ON/OFF
       lcd.clear();
       lcd.print(F("Sensore FILO"));
       delay(1000);
       lcd.clear();
       Menu_Mode_Selection = 0;
       lcd.clear();
       lcd.setCursor(0,0);
       lcd.print(F("Sensore FILO"));
       lcd.setCursor(0,1);
       lcd.print(F("Status : "));
       if (Perimeter_Wire_Enabled == 1) lcd.print(F("ON  "));
       if (Perimeter_Wire_Enabled == 0) lcd.print(F("OFF"));
       
       Menu_Complete_Sensors = false;
       while (Menu_Complete_Sensors == false) {
          Read_Membrane_Keys();
          delay(100);
          //Enter Code Here to Cycle until stop key is pressed.
             if(!Start_Key_X){
               Serial.println(F("Wire Sensor ON/OFF Settings Saved"));
               Menu_Complete_Sensors = true;
               lcd.clear();
               lcd.setCursor(0,0);
               lcd.print(F("Sensore FILO"));
               lcd.setCursor(0,1);
               lcd.print(F("Salvato: "));
               if (Perimeter_Wire_Enabled == 1) lcd.print(F("ON  "));
               if (Perimeter_Wire_Enabled == 0) lcd.print(F("OFF"));
               Serial.print(F("Sensor:"));
               Serial.println(Perimeter_Wire_Enabled);
               delay(2000);
               lcd.clear();          
               EEPROM.write(67 , 1);
               EEPROM.write(68 , Perimeter_Wire_Enabled);
               Menu_Mode_Selection = 0;
               
               }
             if (!Plus_Key_X) {
               lcd.setCursor(0,1);
               lcd.print(F("Stato : "));
               Perimeter_Wire_Enabled = 1;
               lcd.print(F("ON  "));
               Serial.print(F("Sensor:"));
               Serial.println(Perimeter_Wire_Enabled);
               delay(100);
               }
             if (!Minus_Key_X) {
               lcd.setCursor(0,1);
               lcd.print(F("Stato : "));
               Perimeter_Wire_Enabled = 0;
               lcd.print(F("OFF"));
               Serial.print(F("Sensor:"));
               Serial.println(Perimeter_Wire_Enabled);
               delay(100);
               }
     }
     }

   if (Menu_Mode_Selection == 7) {
       // Rain Sensor ON/OFF
       lcd.clear();
       lcd.print(F("Sensore Pioggia"));
       delay(1000);
       lcd.clear();
       Menu_Mode_Selection = 0;
       lcd.clear();
       lcd.setCursor(0,0);
       lcd.print(F("Sensore Pioggia"));
       lcd.setCursor(0,1);
       lcd.print(F("Status : "));
       if (Rain_Sensor_Installed == 1) lcd.print(F("ON  "));
       if (Rain_Sensor_Installed == 0) lcd.print(F("OFF"));
       
       Menu_Complete_Sensors = false;
       while (Menu_Complete_Sensors == false) {
          Read_Membrane_Keys();
          delay(100);
          //Enter Code Here to Cycle until stop key is pressed.
             if(!Start_Key_X){
               Serial.println(F("Rain Sensor ON/OFF Settings Saved"));
               Menu_Complete_Sensors = true;
               lcd.clear();
               lcd.setCursor(0,0);
               lcd.print(F("Sensore Pioggia"));
               lcd.setCursor(0,1);
               lcd.print(F("Salvato: "));
               if (Rain_Sensor_Installed == 1) lcd.print(F("ON  "));
               if (Rain_Sensor_Installed == 0) lcd.print(F("OFF"));
               Serial.print(F("Sensor:"));
               Serial.println(Rain_Sensor_Installed);
               delay(2000);
               lcd.clear();          
               EEPROM.write(77 , 1);
               EEPROM.write(78 , Rain_Sensor_Installed);
               Menu_Mode_Selection = 0;
               
               }
             if (!Plus_Key_X) {
               lcd.setCursor(0,1);
               lcd.print(F("Status : "));
               Rain_Sensor_Installed = 1;
               lcd.print(F("ON  "));
               Serial.print(F("Sensor:"));
               Serial.println(Rain_Sensor_Installed);
               delay(100);
               }
             if (!Minus_Key_X) {
               lcd.setCursor(0,1);
               lcd.print(F("Status : "));
               Rain_Sensor_Installed = 0;
               lcd.print(F("OFF"));
               Serial.print(F("Sensor:"));
               Serial.println(Rain_Sensor_Installed);
               delay(100);
               }
     }
     }

     if (Menu_Mode_Selection == 8) {
       // Rain Sensitivity
       Menu_Mode_Selection = 0;
       delay(500);
       lcd.clear();
       lcd.setCursor(0,0);
       lcd.print(F("Sensib. Pioggia:"));
       lcd.setCursor(0,1);
       lcd.print(F("Hits = "));
       lcd.print(Rain_Total_Hits_Go_Home);
       Serial.print(F("Sens Pioggia = :"));
       Serial.println(Rain_Total_Hits_Go_Home);
       Menu_Complete_Sensors = false;
       while (Menu_Complete_Sensors == false) {
             Read_Membrane_Keys();
             delay(100);
             //Enter Code Here to Cycle until stop key is pressed.
             if(!Start_Key_X){
             Serial.println(F("Settings Saved"));
             Menu_Complete_Sensors = true;
             lcd.clear();
             lcd.setCursor(0,0);
             lcd.print("Hits : ");
             lcd.print(Rain_Total_Hits_Go_Home);
             lcd.setCursor(0,1);
             lcd.print(F("SALVATO"));
             delay(2000);
             lcd.clear();          
             EEPROM.write(79, 1);
             EEPROM.write(80, Rain_Total_Hits_Go_Home);   
             Menu_Mode_Selection = 0;
             }
             if (!Plus_Key_X) {
               Rain_Total_Hits_Go_Home = Rain_Total_Hits_Go_Home + 1;
               if (Rain_Total_Hits_Go_Home> 50) Rain_Total_Hits_Go_Home = 50;
               lcd.clear();
               lcd.setCursor(0,0); 
               lcd.print(F("Sensib Pioggia:"));
               lcd.setCursor(0,1);
               lcd.print(F("Hits = "));
               lcd.print(Rain_Total_Hits_Go_Home);
               Serial.print(F("Sens Pioggia = :"));
               Serial.println(Rain_Total_Hits_Go_Home);
               }
             if (!Minus_Key_X) {
               Rain_Total_Hits_Go_Home = Rain_Total_Hits_Go_Home - 1;
               if (Rain_Total_Hits_Go_Home < 1) Rain_Total_Hits_Go_Home = 1;
               lcd.clear();
               lcd.setCursor(0,0); 
               lcd.print(F("Sensib Pioggia:"));
               lcd.setCursor(0,1);
               lcd.print(F("Hits = "));
               lcd.print(Rain_Total_Hits_Go_Home);
               Serial.print(F("Sens Pioggia = :"));
               Serial.println(Rain_Total_Hits_Go_Home);
               }
             
             }
     }


   if (Menu_Mode_Selection == 9) {
       // WIFI ON/OFF
       lcd.clear();
       lcd.print(F("Funzioni WIFI"));
       delay(1000);
       lcd.clear();
       Menu_Mode_Selection = 0;
       lcd.clear();
       lcd.setCursor(0,0);
       lcd.print(F("Funzioni WIFI"));
       lcd.setCursor(0,1);
       lcd.print(F("Stato: "));
       if (WIFI_Enabled == 1) lcd.print(F("Attivato "));
       if (WIFI_Enabled == 0) lcd.print(F("Disattivato"));
       
       Menu_Complete_Sensors = false;
       while (Menu_Complete_Sensors == false) {
          Read_Membrane_Keys();
          delay(100);
          //Enter Code Here to Cycle until stop key is pressed.
             if(!Start_Key_X){
               Serial.println(F("Rain Sensor ON/OFF Settings Saved"));
               Menu_Complete_Sensors = true;
               lcd.clear();
               lcd.setCursor(0,0);
               lcd.print(F("Funzioni WIFI"));
               lcd.setCursor(0,1);
               lcd.print(F("Salvato: "));
               if (WIFI_Enabled == 1) lcd.print(F("Attivato"));
               if (WIFI_Enabled == 0) lcd.print(F("Disattivato"));
               Serial.print(F("Stato:"));
               Serial.println(WIFI_Enabled);
               delay(2000);
               lcd.clear();          
               EEPROM.write(81 , 1);
               EEPROM.write(82 , WIFI_Enabled);
               Menu_Mode_Selection = 0;
               
               }
             if (!Plus_Key_X) {
               lcd.setCursor(0,1);
               lcd.print(F("Stato: "));
               WIFI_Enabled = 1;
               lcd.print(F("Attivato "));
               Serial.print(F("Status:"));
               Serial.println(WIFI_Enabled);
               delay(100);
               }
             if (!Minus_Key_X) {
               lcd.setCursor(0,1);
               lcd.print(F("Stato: "));
               Rain_Sensor_Installed = 0;
               lcd.print(F("Disattivato"));
               Serial.print(F("Status:"));
               Serial.println(WIFI_Enabled);
               delay(100);
               }
     }
     }

   if (Menu_Mode_Selection == 10) {
       // Bumper Bar ON/OFF
       lcd.clear();
       lcd.print(F("Paraurti"));
       delay(1000);
       lcd.clear();
       Menu_Mode_Selection = 0;
       lcd.clear();
       lcd.setCursor(0,0);
       lcd.print(F("Paraurti"));
       lcd.setCursor(0,1);
       lcd.print(F("Stato : "));
       if (Bumper_Activate_Frnt == 1) lcd.print(F("ON  "));
       if (Bumper_Activate_Frnt == 0) lcd.print(F("OFF"));
       
       Menu_Complete_Sensors = false;
       while (Menu_Complete_Sensors == false) {
          Read_Membrane_Keys();
          delay(100);
          //Enter Code Here to Cycle until stop key is pressed.
             if(!Start_Key_X){
               Serial.println(F("Wire Sensor ON/OFF Settings Saved"));
               Menu_Complete_Sensors = true;
               lcd.clear();
               lcd.setCursor(0,0);
               lcd.print(F("Paraurti"));
               lcd.setCursor(0,1);
               lcd.print(F("Salvato: "));
               if (Bumper_Activate_Frnt == 1) {
                  lcd.print(F("ON  "));
                  Setup_Bumper_Bar();
                  }
               if (Bumper_Activate_Frnt == 0) lcd.print(F("OFF"));
               Serial.print(F("Sensor:"));
               Serial.println(Bumper_Activate_Frnt);
               delay(2000);
               lcd.clear();          
               EEPROM.write(90 , 1);
               EEPROM.write(91 , Bumper_Activate_Frnt);
               Menu_Mode_Selection = 0;
               
               }
             if (!Plus_Key_X) {
               lcd.setCursor(0,1);
               lcd.print(F("Stato : "));
               Bumper_Activate_Frnt = 1;
               lcd.print(F("ON  "));
               Serial.print(F("Sensor:"));
               Serial.println(Bumper_Activate_Frnt);
               delay(100);
               }
             if (!Minus_Key_X) {
               lcd.setCursor(0,1);
               lcd.print(F("Stato : "));
               Bumper_Activate_Frnt = 0;
               lcd.print(F("OFF"));
               Serial.print(F("Sensor:"));
               Serial.println(Bumper_Activate_Frnt);
               delay(100);
               }
         }
     }


   if (Menu_Mode_Selection == 11) {
       // Modulo RPLidar ON/OFF
       lcd.clear();
       lcd.print(F("RPLidar"));
       delay(1000);
       lcd.clear();
       Menu_Mode_Selection = 0;
       lcd.clear();
       lcd.setCursor(0,0);
       lcd.print(F("RPLidar"));
       lcd.setCursor(0,1);
       lcd.print(F("Status : "));
       if (RPLIDAR_Enabled == 1) lcd.print(F("ON  "));
       if (RPLIDAR_Enabled == 0) lcd.print(F("OFF"));
       
       Menu_Complete_Sensors = false;
       while (Menu_Complete_Sensors == false) {
          Read_Membrane_Keys();
          delay(100);
          //Enter Code Here to Cycle until stop key is pressed.
             if(!Start_Key_X){
               Serial.println(F("RPlidar ON/OFF Settings Saved"));
               Menu_Complete_Sensors = true;
               lcd.clear();
               lcd.setCursor(0,0);
               lcd.print(F("RPLidar"));
               lcd.setCursor(0,1);
               lcd.print(F("Salvato: "));
               if (RPLIDAR_Enabled == 1) lcd.print(F("ON  "));
               if (RPLIDAR_Enabled == 0) lcd.print(F("OFF"));
               Serial.print(F("Sensor:"));
               Serial.println(RPLIDAR_Enabled);
               delay(2000);
               lcd.clear();          
               EEPROM.write(159 , 1);
               EEPROM.write(160 , RPLIDAR_Enabled);
               Menu_Mode_Selection = 0;
               
               }
             if (!Plus_Key_X) {
               lcd.setCursor(0,1);
               lcd.print(F("Stato : "));
               RPLIDAR_Enabled = 1;
               lcd.print(F("ON  "));
               Serial.print(F("Sensor:"));
               Serial.println(RPLIDAR_Enabled);
               delay(100);
               }
             if (!Minus_Key_X) {
               lcd.setCursor(0,1);
               lcd.print(F("Stato : "));
               RPLIDAR_Enabled = 0;
               lcd.print(F("OFF"));
               Serial.print(F("Sensor:"));
               Serial.println(RPLIDAR_Enabled);
               delay(100);
               }
     }
     }

     if (Menu_Mode_Selection == 12) {
       // Distanza LIDAR
       Menu_Mode_Selection = 0;
       lcd.clear();
       delay(500);
       lcd.setCursor(0,0);
       lcd.print(F("Distanza LIDAR:"));
       lcd.setCursor(0,1);
       lcd.print(F("Cm = "));
       lcd.print(maxdistanceLIDAR);
       Serial.print(F("Lidar Distance = :"));
       Serial.println(maxdistanceLIDAR);
       Menu_Complete_Sensors = false;
       while (Menu_Complete_Sensors == false) {
             Read_Membrane_Keys();
             delay(100);
             //Enter Code Here to Cycle until stop key is pressed.
             if(!Start_Key_X){
             Serial.println(F("Settings Saved"));
             Menu_Complete_Sensors = true;
             lcd.clear();
             lcd.setCursor(0,0);
             lcd.print(F("mm = "));
             lcd.print(maxdistanceLIDAR);
             lcd.setCursor(0,1);
             lcd.print(F("SALVATO"));
             delay(2000);
             lcd.clear();          
             EEPROM.write(161, 1);
             EEPROM.write(162, maxdistanceLIDAR);   
             Menu_Mode_Selection = 0;
             }
             if (!Plus_Key_X) {
               maxdistanceLIDAR = maxdistanceLIDAR + 10;
               if (maxdistanceLIDAR> 1000) maxdistanceLIDAR = 1000;
               lcd.clear();
               lcd.setCursor(0,0);
               lcd.print(F("Distanza LIDAR:"));
               lcd.setCursor(0,1);
               lcd.print(F("mm = "));
               lcd.print(maxdistanceLIDAR);
               Serial.print(F("Distan LIDAR = :"));
               Serial.println(maxdistanceLIDAR);
               }
             if (!Minus_Key_X) {
               maxdistanceLIDAR = maxdistanceLIDAR - 10;
               if (maxdistanceLIDAR < 250) maxdistanceLIDAR = 250;
               lcd.clear();
               lcd.setCursor(0,0);
               lcd.print(F("Distanza LIDAR:"));
               lcd.setCursor(0,1);
               lcd.print(F("mm = "));
               lcd.print(maxdistanceLIDAR);
               Serial.print(F("Distan LIDAR = :"));
               Serial.println(maxdistanceLIDAR);
               }
             
             }
     }

if (Menu_Complete_Sensors = true) Print_Membrane_Switch_Input_Sensors();
}
