Marcobedendo78/Robot-Arduino-4.0/Upgrade doppi sensori filo e lipo 8s/MEGA_V1_8/Manovre.ino

// Le manovre sono un insieme di funzioni di movimento o azioni motorie che vengono chiamate regolarmente
// e.g. Turn the mower around

// Sposta il tosaerba in avanti nel giardino e attiva le funzioni della bussola se abilitate
void Manouver_Mow_The_Grass() {

  // --- variabili statiche per lo stato del run per la rampa di accelerazione ---
  static int  lastCycle = -1;                                        // per rilevare l'inizio di un nuovo run (Loop_Cycle_Mowing torna a 0)
  static bool ramp_done_this_run = false;                            // rampa eseguita in questo run?


    Motor_Action_Spin_Blades();
    SetPins_ToGoForwards();

  // Nuovo run rilevato: il contatore è (tornato) a 0 o minore di 2 → ri-arma la rampa per questo run
  if (Loop_Cycle_Mowing == 0) {
    CalibraGyroZ();                                                  // Calibra solo all'inizio del run
    ramp_done_this_run = false;                                      // <-- PATCH QUI
  }


  // Rampa di accelerazione non bloccante (solo una volta per run)
  if (!ramp_done_this_run) {
    if (!Motor_Action_SoftStart_IsActive()) {
      Motor_Action_SoftStart_To_Mow(RAMP_TIME_MS);                   // avvia rampa (tuning 600–1500 ms)
    } else {
      Motor_Action_SoftStart_To_Mow(0);                              // aggiorna rampa
      if (!Motor_Action_SoftStart_IsActive()) {
        ramp_done_this_run = true;                                   // rampa conclusa per questo run
      }
    }

    // Finché la rampa è attiva, non eseguire altro che possa toccare i PWM.
    if (!ramp_done_this_run) {
      // Early-return: evita di riscrivere PWM con altre funzioni
      lastCycle = Loop_Cycle_Mowing;
      Loop_Cycle_Mowing++;
      return;                                                        // evita che il codice sotto riscriva i PWM durante la rampa
    }
  }

  // ----- DA QUI IN POI: controllo normale (rampa finita per questo run) -----


    Loop_Cycle_Mowing++;
    Serial.print(F("Loop:"));
    Serial.print(Loop_Cycle_Mowing);
    Serial.print(F("|"));
    lcd.setCursor(14, 1);
    delay(1);

    if (Loop_Cycle_Mowing < 3) {                       
        Serial.print(F("C-Lock:OFF"));
        Serial.print(F("|"));
        Print_LCD_Mowing();
        if ((Compass_Heading_Hold_Enabled == 1) && (GYRO_Enabled == 1)) {
            //Get_GYRO_Reading();
            Controllo_PID_Gyro(Gyro_Heading);
        } else {
            Motor_Action_Go_Full_Speed();
        }
    }

    if (Loop_Cycle_Mowing == 3) {
        if (Pattern_Mow == 0) {
            if ((Compass_Heading_Hold_Enabled == 1) && (GYRO_Enabled == 1)) {
                //Get_GYRO_Reading();
                Controllo_PID_Gyro(Gyro_Heading);
                GYRO_Heading_Locked = 0;
            } else {
                Serial.print(F("C-Lock:OFF"));
                Serial.print(F("|"));
                Print_LCD_Compass_Mowing();
                Motor_Action_Go_Full_Speed();
                Serial.println(F("Gyro non attivato"));
                Compass_Heading_Locked = 0;
            }
        }

        if (Pattern_Mow == 1) {
            Print_LCD_Parallel();
            Serial.print(F("Parallel:ON"));
            Serial.print(F("|"));
            if ((Compass_Heading_Hold_Enabled == 1) && (GYRO_Enabled == 1)) {
                //Get_GYRO_Reading();
                Controllo_PID_Gyro(Gyro_Heading);
                GYRO_Heading_Locked = 0;
            } else {
                Motor_Action_Go_Full_Speed();
                Serial.println(F("Gyro non attivato"));
            }
        }

        if (Pattern_Mow == 2) {
            Compass_Heading_Locked = 0;
            Print_LCD_Spiral();
            Serial.print(F("Spiral:ON"));
            Serial.print(F("|"));
            //Get_GYRO_Reading();
            Controllo_PID_Gyro(Gyro_Heading);
            GYRO_Heading_Locked = 0;
        }
    }

    if (Loop_Cycle_Mowing > 3) {
        if (Pattern_Mow == 0) {
            if (Compass_Heading_Locked == 0) {
                lcd.setCursor(0, 1);
                Serial.print(F("C-Lock:OFF"));
                Serial.print(F("|"));
                lcd.print("Falciatura     ");
                Motor_Action_Go_Full_Speed();
                Compass_Steering_Status = 0;
            }
            if ((Compass_Heading_Hold_Enabled == 1) && (GYRO_Enabled == 1)) {
                if ((Loop_Cycle_Mowing % 2) == 0) {
                    Print_LCD_Compass_Mowing();
                    Serial.print(F("C-Lock:ON_"));
                    Serial.print(F("|"));
                    //Get_GYRO_Reading();
                    Controllo_PID_Gyro(Gyro_Heading);
                    GYRO_Heading_Locked = 0;
                }
            }
        }

        if (Pattern_Mow == 1) {
            Pattern_Mow_Parallel();
        }

        if (Pattern_Mow == 2) {
            Pattern_Mow_Spirals();
        }
    }

    int Max_Cycles_Active;
    if (Pattern_Mow != 2) Max_Cycles_Active = Max_Cycles_Straight;
    if ((Pattern_Mow == 2) && (Spiral_Mow == 3)) Max_Cycles_Active = Max_Cycles_Straight;
    if ((Pattern_Mow == 2) && (Spiral_Mow < 3)) Max_Cycles_Active = Max_Cycles_Spirals;

    if (Loop_Cycle_Mowing > Max_Cycles_Active) {
        Serial.println("");
        Serial.println(F("Loop Cycle at Max"));
        Serial.println("");
        Motor_Action_Stop_Spin_Blades();
        Manouver_Turn_Around();

        // Dopo la rotazione
        Get_GYRO_Reading();                                   // Leggi heading attuale
        targetHeading = Gyro_Heading;                         // Imposta la direzione attuale come nuovo target
        pid_integral = 0;                                     // Reset integrale PID
        pid_lastError = 0;                                    // Reset derivata
        lastTime = millis();                                  // Reset tempo per deltaTime


        Loop_Cycle_Mowing = 0;
        lcd.clear();
        // ramp_done_this_run verrà ri-armato automaticamente al prossimo ingresso
        // grazie alla detection "Loop_Cycle_Mowing == 0 && lastCycle != 0"
    }
}

 
 

// Turn Around definisce come deve reagire il tagliaerba quando viene attivato un cavo o un sensore sonar.
// Ora con il taglio a spirale si decide anche la logica di quale forma a spirale sarà la prossima

void Manouver_Turn_Around() {
    Motor_Action_Stop_Motors();
    if (Outside_Wire == 1)             Serial. println ( F ( "Il tagliaerba è fuori dal cavo" )); 
    if (Wheel_Blocked == 4)            Serial.println(F("Le ruote del tagliaerba sono inceppate"));
    delay(1000);                                                                //Prima 500
    // Prima della rotazione
    GYRO_Heading_Locked = 0;                                                    // Disattiva correzione direzionale
    

    // Eseguire il backup del tosaerba
    SetPins_ToGoBackwards();
    Motor_Action_Go_Accel(Mower_Reverse_Delay);
    Motor_Action_Stop_Motors(); 
    delay(1000);                                                                 //Prima 200

        if (Perimeter_Wire_Enabled == 1) {
        Check_Wire_In_Out();
    
        if (Outside_Wire == 1) { 
            for (int i = 0; i < 5; i++) {
             delay(10);                                                             
             ADCMan.run();
             UpdateWireSensor();
             delay(10);
             ADCMan.run();
             UpdateWireSensor();
             delay(10);
             PrintBoundaryWireStatus();
            }
            

          UpdateWireSensor();
          Check_Wire_In_Out();
              if (Outside_Wire == 1) { 
                SetPins_ToGoBackwards();
                Motor_Action_Go_Accel(600);                               
                Motor_Action_Stop_Motors();
                delay(1000);
                UpdateWireSensor();
                Check_Wire_In_Out();
               }
           } 
      }


    // Decidere casualmente se il tagliaerba deve girare a sinistra oa destra a seconda che il ciclo del ciclo sia pari o dispari
    if ( (Loop_Cycle_Mowing % 2) == 0 ) {
     SetPins_ToTurnRight(); 
    }
    else SetPins_ToTurnLeft();
 

    // Ruota casualmente il tagliaerba su una nuova rotta a seconda del ritardo Min o Delay Max dalle impostazioni
    Motor_Action_Go_Accel(random(Mower_Turn_Delay_Min, Mower_Turn_Delay_Max));
    //Motor_Action_Turn_Speed();
    //delay (random(Mower_Turn_Delay_Min, Mower_Turn_Delay_Max));
    //Serial.println("");
    //Serial.println(F("Mower Turned Around"));
    //Serial.println("");

    // Se la modalità Spirale è attivata
    // Fa avanzare il tipo di movimento in modalità Pattern Spiral da: 1 Spirale destra | 2 Spirale sinistra | 3 Linea retta.
    if (Pattern_Mow == 2) {
    Spiral_Mow = (Spiral_Mow + 1);
    if (Spiral_Mow > 3) Spiral_Mow = 1;
    }
    //Spirale (casuale (1,3)); Attivalo per creare un vero modello casuale.

    Motor_Action_Stop_Motors();
    delay(1000);

    // Se il cavo perimetrale è abilitato
    // Verificare che il tagliaerba si sia girato e sia tornato all'interno del cavo perimetrale.
    

    Bumper = 0;                                                           // Reset Paraurti
    Loop_Cycle_Mowing = 0;                                                // Rest Cicli Loop
    Sonar_Hit = 0;                                                        // Reset Sonar 
    distance1 = 999;
    distance2 = 999;
    distance3 = 999;
    Sonar_Hit_1_Total = 0;
    Sonar_Hit_2_Total = 0;
    Sonar_Hit_3_Total = 0;
    Compass_Heading_Locked = 0;                                           // Reset Compass Heading Lock
    // Dopo la rotazione
    Get_GYRO_Reading();                                                   // Leggi heading attuale
    targetHeading = Gyro_Heading;                                         // Imposta la direzione attuale come nuovo target
    pid_integral = 0;                                                     // Reset integrale PID
    pid_lastError = 0;                                                    // Reset derivata
    lastTime = millis();                                                  // Reset tempo per deltaTime
    lcd.clear();
    // --- NUOVO RUN: prepara la rampa ---
    analogWrite(ENAPin, 0);                                               // azzera subito PWM motore DX
    analogWrite(ENBPin, 0);                                               // azzera subito PWM motore SX
    Compass_Heading_Locked = 0;                                           // Reset Compass Heading Lock
    delay(500);
}


void Manouver_Turn_Around_Sonar() {
  Motor_Action_Stop_Motors(); 
  delay(500);
  GYRO_Heading_Locked = 0;                                                    // Disattiva correzione direzionale
  SetPins_ToGoBackwards();
  Motor_Action_Go_Accel(Mower_Reverse_Delay);
  Motor_Action_Stop_Motors(); 
  delay(1000);
     
  if (distance2 < maxdistancesonar && distance3 < maxdistancesonar) {
      int scelta = random(0, 2);  // 0 = destra, 1 = sinistra

      if (scelta == 0) {
        lcd.setCursor(0, 8);
        lcd.print("Rnd: DX -->   ");
        SetPins_ToTurnRight(); 
      } else {
        lcd.setCursor(0, 8);
        lcd.print("Rnd: <-- SX   ");
        SetPins_ToTurnLeft(); 
      }

      Motor_Action_Go_Accel(Mower_Turn_Delay_Min);
      //Motor_Action_Turn_Speed ();
      //delay(Mower_Turn_Delay_Min);
      Motor_Action_Stop_Motors();
      Check_Sonar_Sensors();
      delay(1000);
  }

  else if (distance2 < maxdistancesonar) {  // Solo se il Sonar 2 SX legge gira a DX
      lcd.setCursor(0, 8);
      lcd.print("Gira a DX -->   ");
      SetPins_ToTurnRight();
      Motor_Action_Go_Accel(Mower_Turn_Delay_Min); 
      //Motor_Action_Turn_Speed ();
      //delay(Mower_Turn_Delay_Min);
      Motor_Action_Stop_Motors();
      Check_Sonar_Sensors();
      delay(1000);
  }

  else if (distance3 < maxdistancesonar) {  // Solo se il Sonar 3 DX legge gira a SX
      lcd.setCursor(0, 8);
      lcd.print("<-- Gira a SX   ");
      SetPins_ToTurnLeft();
      Motor_Action_Go_Accel(Mower_Turn_Delay_Min);
      //Motor_Action_Turn_Speed();
      //delay(Mower_Turn_Delay_Min);
      Motor_Action_Stop_Motors();
      Check_Sonar_Sensors();
      delay(1000);
  }

  Motor_Action_Stop_Motors();
  delay(500);

  Compass_Heading_Locked = 0;
  Sonar_Hit = 0;
  Loop_Cycle_Mowing = 0;
  // Dopo la rotazione
  Get_GYRO_Reading();                                                   // Leggi heading attuale
  targetHeading = Gyro_Heading;                                         // Imposta la direzione attuale come nuovo target
  pid_integral = 0;                                                     // Reset integrale PID
  pid_lastError = 0;                                                    // Reset derivata
  lastTime = millis();                                                  // Reset tempo per deltaTime
  Check_Sonar_Sensors();
  Compass_Heading_Locked = 0;                                           // Reset Compass Heading Lock
  delay(500);
}




void Manouver_Manuel_Mode() {
  Mower_Docked          = 0;
  Mower_Parked          = 0;
  Mower_Running         = 0;
  Mower_Parked_Low_Batt = 0;
  Mower_Track_To_Exit   = 0;
  Mower_Track_To_Charge = 0;
  Mower_Error           = 0;
  Manuel_Mode           = 1;
  Loop_Cycle_Mowing     = 0;
  Motor_Action_Stop_Motors();
  Motor_Action_Stop_Spin_Blades();
  StopLidarMotor();                                       // Ferma il motore del LIDAR
  if (WIFI_Enabled == 1) Get_WIFI_Commands();
  
}


void Manouver_Start_Mower() {
  GYRO_Heading_Locked   = 0;                              // Disattiva correzione direzionale
  Mower_Docked          = 0;
  Mower_Parked          = 0;
  Mower_Running         = 1;
  Mower_Parked_Low_Batt = 0;
  Mower_Track_To_Charge = 0;
  Rain_Hit_Detected     = 0;
  Mower_Error           = 0;
  Loop_Cycle_Mowing     = 0;
  Manuel_Mode           = 0;
  Wire_Refind_Tries     = 0;
  Turn_On_Relay();
  Y_Tilt = 0;
  if (WIFI_Enabled == 1) Get_WIFI_Commands();
  // Dopo la rotazione
    Get_GYRO_Reading();                                             // Leggi heading attuale
    targetHeading = Gyro_Heading;                                   // Imposta la direzione attuale come nuovo target
    pid_integral = 0;                                               // Reset integrale PID
    pid_lastError = 0;                                              // Reset derivata
    lastTime = millis();                                            // Reset tempo per deltaTime
  }

void Manouver_Mower_Exit_Dock() {

  Mower_Docked          = 0;
  Mower_Parked          = 0;
  Mower_Running         = 0;
  Mower_Parked_Low_Batt = 0;
  Rain_Hit_Detected     = 0;
  Mower_Error           = 0;
  Manuel_Mode           = 0;
  Tracking_Wire         = 0;  
  if (WIFI_Enabled == 1) Get_WIFI_Commands();
  }

void Manouver_Dock_The_Mower() {
  Mower_Docked          = 1;
  Mower_Parked          = 0;
  Mower_Running         = 0;
  Mower_Parked_Low_Batt = 0;
  Mower_Track_To_Exit   = 0;
  Mower_Track_To_Charge = 0;
  Mower_Error           = 0;
  Loop_Cycle_Mowing     = 0;
  Manuel_Mode           = 0;
  Motor_Action_Stop_Motors();
  Motor_Action_Stop_Spin_Blades();
  Turn_Off_Relay();
  Print_LCD_Info_Docked();
  Charge_Detected_MEGA = 0;
  if (WIFI_Enabled == 1) Get_WIFI_Commands();
  
  //Setup Alarms 
  Alarm_Timed_Mow_ON = 0;                                           // Turns off the 1 hr Alarm
 
}

// Il tagliaerba è una posizione parcheggiata e necessita di ricarica manuale
void Manouver_Park_The_Mower_Low_Batt() {
  
  Mower_Docked          = 0;
  Mower_Parked          = 0;
  Mower_Running         = 0;
  Mower_Parked_Low_Batt = 1;
  Mower_Track_To_Charge = 0;
  Mower_Error           = 0;
  Loop_Cycle_Mowing     = 0;
  Manuel_Mode           = 0;
  Motor_Action_Stop_Motors();
  Motor_Action_Stop_Spin_Blades();
  StopLidarMotor();                                       // Ferma il motore del LIDAR

}


// Il tagliaerba è in una posizione parcheggiata o in pausa pronto per il riavvio
void Manouver_Park_The_Mower() {

  // Se era in ricerca filo, annullo quella modalità
  if (Tracking_Wire == 1 || Mower_Track_To_Exit == 1 || Mower_Track_To_Charge == 1) {
    Serial.println(F("Annullamento ricerca filo o tracking in corso"));
    Tracking_Wire = 0;
    Mower_Track_To_Exit = 0;
    Mower_Track_To_Charge = 0;
  }

  Mower_Docked          = 0;
  Mower_Parked          = 1;
  Mower_Running         = 0;
  Mower_Parked_Low_Batt = 0;
  Mower_Error           = 0;
  Loop_Cycle_Mowing     = 0;
  Manuel_Mode           = 0;

  Motor_Action_Stop_Motors();
  Motor_Action_Stop_Spin_Blades();
  Turn_Off_Relay();
  StopLidarMotor();  // Ferma il motore del LIDAR

  if (WIFI_Enabled == 1) Get_WIFI_Commands();

  Alarm_Timed_Mow_ON = 0; // Disattiva l’allarme 1h

  // ✅ Mostra stato sul display con riga superiore vuota
  lcd.clear();
  lcd.setCursor(0, 1);
  lcd.print("  Parcheggiato  ");
}


void Manouver_Hibernate_Mower() {

  Mower_Docked          = 0;
  Mower_Parked          = 1;                     // Prima era 0   03/08/2022                                
  Mower_Running         = 0;
  Mower_Parked_Low_Batt = 0;
  Mower_Track_To_Charge = 0;
  Tracking_Wire         = 0;
  Mower_Track_To_Exit   = 0;
  Mower_Error           = 0;                     // Prima era 1    03/08/2022
  Loop_Cycle_Mowing     = 0;
  Manuel_Mode           = 0;
  Motor_Action_Stop_Motors();
  Motor_Action_Stop_Spin_Blades();
  Turn_Off_Relay();
  StopLidarMotor();                                       // Ferma il motore del LIDAR
  }

// Il rasaerba viene inviato alla stazione di ricarica dopo il rilevamento di bassi voltaggi o l'inserimento di una chiave a membrana.
void Manouver_Go_To_Charging_Station() {
  Mower_Docked          = 0;
  Mower_Parked          = 0;
  Mower_Running         = 0;
  Mower_Parked_Low_Batt = 0;
  Mower_Track_To_Charge = 1;
  Tracking_Wire         = 1;
  Mower_Track_To_Exit   = 0;
  Mower_Error           = 0;
  Loop_Cycle_Mowing     = 0;
  Manuel_Mode           = 0;
  No_Wire_Found_Fwd     = 0;
  No_Wire_Found_Bck     = 0;
  Manage_Alarms();                                              // Switches on or off the Alarms depending on the setup
  if (WIFI_Enabled == 1) Get_WIFI_Commands();
  delay(5);
  Motor_Action_Stop_Spin_Blades();                            
  Motor_Action_Stop_Motors();
  delay(2000);
  Turn_On_Relay();
  delay(500);
  if (WIFI_Enabled == 1) Get_WIFI_Commands();
  if ((Compass_Activate == 1) && (Mower_Parked ==0))        Compass_Turn_Mower_To_Home_Direction();
  if (WIFI_Enabled == 1) Get_WIFI_Commands();
  if (Mower_Parked == 0)                                    Manouver_Find_Wire_Track();
  if (WIFI_Enabled == 1) Get_WIFI_Commands();
  if ((Mower_Parked == 0) && (No_Wire_Found_Fwd == 0))      Track_Perimeter_Wire_To_Dock();
  if (WIFI_Enabled == 1) Get_WIFI_Commands();
  if (No_Wire_Found_Fwd == 1)                               Manouver_Go_To_Charging_Station();
  if (WIFI_Enabled == 1) Get_WIFI_Commands();

  }

// Il rasaerba viene inviato alla stazione di ricarica dopo il rilevamento di bassi voltaggi o l'inserimento di una chiave a membrana se gira attorno ad un'aiuola.
void Manouver_Go_To_Charging_Station_2() {
  Mower_Docked          = 0;
  Mower_Parked          = 0;
  Mower_Running         = 0;
  Mower_Parked_Low_Batt = 0;
  Mower_Track_To_Charge = 1;
  Tracking_Wire         = 1;
  Mower_Track_To_Exit   = 0;
  Mower_Error           = 0;
  Loop_Cycle_Mowing     = 0;
  Manuel_Mode           = 0;
  No_Wire_Found_Fwd     = 0;
  No_Wire_Found_Bck     = 0;
  Manage_Alarms();                                              // Switches on or off the Alarms depending on the setup
  if (WIFI_Enabled == 1) Get_WIFI_Commands();
  delay(5);
  Motor_Action_Stop_Spin_Blades();                            
  Motor_Action_Stop_Motors();
  delay(2000);
  Turn_On_Relay();
  delay(500);
  if (WIFI_Enabled == 1) Get_WIFI_Commands();
  if (Mower_Parked == 0)                                    Manouver_Find_Wire_Track();
  if (WIFI_Enabled == 1) Get_WIFI_Commands();
  if ((Mower_Parked == 0) && (No_Wire_Found_Fwd == 0))      Track_Perimeter_Wire_To_Dock();
  if (WIFI_Enabled == 1) Get_WIFI_Commands();
  if (No_Wire_Found_Fwd == 1)                               Manouver_Go_To_Charging_Station();
  if (WIFI_Enabled == 1) Get_WIFI_Commands();

  }

  
void Manouver_Exit_To_Zone_X() {
   // Zone 1 or Zone 2 and the Wire itterations are set on the Membrane Buttons.
   // These values are then crried into the following functions.  
   Turn_On_Relay();
   delay(1000);
   Manouver_Mower_Exit_Dock();
   Special_Exit_From_Docking_Station();                         // Move the Mower into position backing out of the docking station
   if (Perimeter_Wire_Enabled == 1) {
     Mower_Track_To_Exit = 1;
     TestforBoundaryWire();
     delay(50);
     if (Wire_Detected == 1) {
       if (WIFI_Enabled == 1) Get_WIFI_Commands();
       Manouver_Find_Wire_Track_Exit();                                   // Located the boundary wire
       if (WIFI_Enabled == 1) Get_WIFI_Commands();
       if (Mower_Parked == 0) Track_Wire_From_Dock_to_Zone_X();
       if (WIFI_Enabled == 1) Get_WIFI_Commands();
       if (Mower_Parked == 0) Special_Move_Into_Garden_Zone_X();
       if (WIFI_Enabled == 1) Get_WIFI_Commands();
       if (Mower_Parked == 0) Manouver_Start_Mower();
       if (WIFI_Enabled == 1) Get_WIFI_Commands();
       if (Mower_Parked == 1) Manouver_Park_The_Mower();
     }
    if (Wire_Detected == 0) {
        TestforBoundaryWire();                                      // Test again for the boundary wire
          if (Wire_Detected == 0) {                                 // if its still saying the wire is off then park the mower.
          Serial.println("");
          Serial.println(F("Perimeter Wire not detected"));
          Manouver_Park_The_Mower();
          }
        }   
    }
  if (Perimeter_Wire_Enabled == 0) {
       Serial.println("");
       Serial.println(F("Perimeter Wire not activated in settings"));
       Manouver_Park_The_Mower();
  }
}


// Funzione per ritrovare il cavo se il rasaerba perde il cavo durante il taglio
// 3 al di fuori del filo attiva questa funzione. La funzione sonar e filo viene quindi utilizzata per ritrovare il filo.
void Manouver_Outside_Wire_ReFind_Function(){
    Motor_Action_Stop_Spin_Blades(); 
    lcd.clear();
    lcd.print("Cercando il Filo");
    lcd.setCursor(0,1);
    lcd.print("Filo di Nuovo...");
    ADCMan.run();
    UpdateWireSensor();
    delay(40);                                                           // Prima era 20
    PrintBoundaryWireStatus();
    ADCMan.run();
    UpdateWireSensor();
    delay(40);                                                           // Prima era 20
    PrintBoundaryWireStatus();
  while (inside == false) {                                              // If the mower is outside the wire then run the following code.
     ADCMan.run();
     UpdateWireSensor();
     PrintBoundaryWireStatus();
     //Check_Wire_In_Out();
     delay(500);
     distance_blockage = PingSonarX(trigPin1, echoPin1, 1, 1, 1, 4, 0);
     delay(500);
     Serial.print(F("Distance measured from sonar :"));
     Serial.println(distance_blockage);
     
     // if the sonar is measuring an opening as the distance is greater than 300cm then move forward in that direction.
     if (distance_blockage > 400) {
      while ( (inside == false) && (distance_blockage > 400) ){
        SetPins_ToGoForwards();
        Motor_Action_Go_Full_Speed();
        delay(500);
        ADCMan.run();
        UpdateWireSensor();
        PrintBoundaryWireStatus();
        distance_blockage = PingSonarX(trigPin1, echoPin1, 1, 1, 1, 4, 0); 
        delay(10);
        Check_Wire_In_Out();
      }
     Motor_Action_Stop_Motors;
     ADCMan.run();
     UpdateWireSensor();
     PrintBoundaryWireStatus();
     }

     // if the sonar is measuring something less than 300cm then turn to the left and measure again
     // keep turning 'while function' until a path is open.
     while (distance_blockage < 300) {
       SetPins_ToTurnLeft();
       delay(200);
       Motor_Action_Turn_Speed();                                                             
       delay(100); 
       distance_blockage = PingSonarX(trigPin1, echoPin1, 1, 1, 1, 4, 0); 
       delay(10);
     }
     Motor_Action_Stop_Motors;
     ADCMan.run();
     UpdateWireSensor();
     PrintBoundaryWireStatus();
  }

   Serial.println(F("Mower is now back inside the wire......?"));
   lcd.clear();
   lcd.print("Falciatura Ora");
   lcd.setCursor(0,1);
   lcd.print("Dentro il Filo?");
   Outside_Wire_Count = 0;
   //FindWireTrack();
}
