Marcobedendo78/Robot-Arduino-4.0/Upgrade doppi sensori filo e lipo 8s/MEGA_V1_8/EEPROM.ino

// Carica i valori salvati dalla EEPROM
// al menu delle impostazioni.

void Load_EEPROM_Saved_Data() {

Serial.println("*** Settaggi EEPROM ***");
  
  Alarm_1_Saved_EEPROM = EEPROM.read(1);
  
  if (Alarm_1_Saved_EEPROM == 1) {
    Alarm_1_Hour    = EEPROM.read(2);
    Alarm_1_Minute  = EEPROM.read(3);
    Alarm_1_ON      = EEPROM.read(4);
    Alarm_1_Action  = EEPROM.read(87);
    Serial.print(F("Alarm 1 time from EEPROM "));
    Serial.print(Alarm_1_Hour);
    Serial.print(F(":"));
    if (Alarm_1_Minute < 10) Serial.print("0");
    Serial.println(Alarm_1_Minute);
    Serial.print("Alarm Action 1 =");
    if (Alarm_1_ON == 0) Serial.println(" | Alarm 1 OFF");
    if (Alarm_1_ON == 1) Serial.println(" | Alarm 1 Active");
    if (Alarm_1_Action == 1) Serial.println("Exit Zone 1");
    if (Alarm_1_Action == 2) Serial.println("Exit Zone 2");
    if (Alarm_1_Action == 3) Serial.println("Mow the Line");
    if (Alarm_1_Action == 4) Serial.println("Quick Start");
    if (Alarm_1_Action == 5) Serial.println("Custom");
    }

    
  Alarm_2_Saved_EEPROM = EEPROM.read(5);
  
  if (Alarm_2_Saved_EEPROM == 1) {
    Alarm_2_Hour    = EEPROM.read(6);
    Alarm_2_Minute  = EEPROM.read(7);
    Alarm_2_ON      = EEPROM.read(8);
    Alarm_2_Action  = EEPROM.read(88);
    Serial.print(F("Alarm 2 time from EEPROM "));
    Serial.print(Alarm_2_Hour);
    Serial.print(F(":"));
    if (Alarm_2_Minute < 10) Serial.print("0");
    Serial.print(Alarm_2_Minute);
    if (Alarm_2_ON == 0) Serial.println(" | Alarm 2 OFF");
    if (Alarm_2_ON == 1) Serial.println(" | Alarm 2 Active");
    if (Alarm_2_Action == 1) Serial.println("Exit Zone 1");
    if (Alarm_2_Action == 2) Serial.println("Exit Zone 2");
    if (Alarm_2_Action == 3) Serial.println("Mow the Line");
    if (Alarm_2_Action == 4) Serial.println("Quick Start");
    if (Alarm_2_Action == 5) Serial.println("Custom");
    }

  Alarm_3_Saved_EEPROM = EEPROM.read(9);
  
  if (Alarm_3_Saved_EEPROM == 1) {
    Alarm_3_Hour    = EEPROM.read(10);
    Alarm_3_Minute  = EEPROM.read(11);
    Alarm_3_ON      = EEPROM.read(12);
    Alarm_3_Action  = EEPROM.read(89);
    Serial.print(F("Alarm 3 time from EEPROM "));
    Serial.print(Alarm_3_Hour);
    Serial.print(F(":"));
    if (Alarm_3_Minute < 10) Serial.print("0");
    Serial.print(Alarm_3_Minute);
    if (Alarm_3_ON == 0) Serial.println(" | Alarm 3 OFF");
    if (Alarm_3_ON == 1) Serial.println(" | Alarm 3 Active");
    if (Alarm_3_Action == 1) Serial.println("Exit Zone 1");
    if (Alarm_3_Action == 2) Serial.println("Exit Zone 2");
    if (Alarm_3_Action == 3) Serial.println("Mow the Line");
    if (Alarm_3_Action == 4) Serial.println("Quick Start");
    if (Alarm_3_Action == 5) Serial.println("Custom");
    }


  Alarm_4_Saved_EEPROM = EEPROM.read(130);
  
  if (Alarm_4_Saved_EEPROM == 1) {
    Alarm_4_Hour    = EEPROM.read(131);
    Alarm_4_Minute  = EEPROM.read(132);
    Alarm_4_ON      = EEPROM.read(133);
    Alarm_4_Action  = EEPROM.read(134);
    Serial.print(F("Alarm 4 time from EEPROM "));
    Serial.print(Alarm_4_Hour);
    Serial.print(F(":"));
    if (Alarm_4_Minute < 10) Serial.print("0");
    Serial.print(Alarm_4_Minute);
    if (Alarm_4_ON == 0) Serial.println(" | Alarm 4 OFF");
    if (Alarm_4_ON == 1) Serial.println(" | Alarm 4 Active");
    if (Alarm_4_Action == 1) Serial.println("Exit Zone 1");
    if (Alarm_4_Action == 2) Serial.println("Exit Zone 2");
    if (Alarm_4_Action == 3) Serial.println("Mow the Line");
    if (Alarm_4_Action == 4) Serial.println("Quick Start");
    if (Alarm_4_Action == 5) Serial.println("Custom");
    }


  Alarm_5_Saved_EEPROM = EEPROM.read(135);
  
  if (Alarm_5_Saved_EEPROM == 1) {
    Alarm_5_Hour    = EEPROM.read(136);
    Alarm_5_Minute  = EEPROM.read(137);
    Alarm_5_ON      = EEPROM.read(138);
    Alarm_5_Action  = EEPROM.read(139);
    Serial.print(F("Alarm 5 time from EEPROM "));
    Serial.print(Alarm_5_Hour);
    Serial.print(F(":"));
    if (Alarm_5_Minute < 10) Serial.print("0");
    Serial.print(Alarm_5_Minute);
    if (Alarm_5_ON == 0) Serial.println(" | Alarm 5 OFF");
    if (Alarm_5_ON == 1) Serial.println(" | Alarm 5 Active");
    if (Alarm_5_Action == 1) Serial.println("Exit Zone 1");
    if (Alarm_5_Action == 2) Serial.println("Exit Zone 2");
    if (Alarm_5_Action == 3) Serial.println("Mow the Line");
    if (Alarm_5_Action == 4) Serial.println("Quick Start");
    if (Alarm_5_Action == 5) Serial.println("Custom");
    }


  Alarm_6_Saved_EEPROM = EEPROM.read(140);
  
  if (Alarm_6_Saved_EEPROM == 1) {
    Alarm_6_Hour    = EEPROM.read(141);
    Alarm_6_Minute  = EEPROM.read(142);
    Alarm_6_ON      = EEPROM.read(143);
    Alarm_6_Action  = EEPROM.read(144);
    Serial.print(F("Alarm 6 time from EEPROM "));
    Serial.print(Alarm_6_Hour);
    Serial.print(F(":"));
    if (Alarm_6_Minute < 10) Serial.print("0");
    Serial.print(Alarm_6_Minute);
    if (Alarm_6_ON == 0) Serial.println(" | Alarm 6 OFF");
    if (Alarm_6_ON == 1) Serial.println(" | Alarm 6 Active");
    if (Alarm_6_Action == 1) Serial.println("Exit Zone 1");
    if (Alarm_6_Action == 2) Serial.println("Exit Zone 2");
    if (Alarm_6_Action == 3) Serial.println("Mow the Line");
    if (Alarm_6_Action == 4) Serial.println("Quick Start");
    if (Alarm_6_Action == 5) Serial.println("Custom");
    }

    

  PWM_LEFT_EEPROM = EEPROM.read(13);
  if (PWM_LEFT_EEPROM == 1) {
    PWM_MaxSpeed_LH = EEPROM.read(14);
    Serial.print(F("PWM Wheel Left value from EEPROM : "));
    Serial.println(PWM_MaxSpeed_LH);
  }

  PWM_RIGHT_EEPROM = EEPROM.read(15);
  if (PWM_RIGHT_EEPROM == 1) {
    PWM_MaxSpeed_RH = EEPROM.read(16); 
    Serial.print(F("PWM Wheel Right value from EEPROM : ")); 
    Serial.println(PWM_MaxSpeed_RH);
  }

  int PWM_LEFT_Slow_EEPROM = EEPROM.read(94);
  if (PWM_LEFT_Slow_EEPROM == 1) {
    PWM_Slow_Speed_LH = EEPROM.read(95);
    Serial.print(F("PWM Wheel Wire Left value from EEPROM : "));
    Serial.println(PWM_Slow_Speed_LH);
  }

  int PWM_RIGHT_Slow_EEPROM = EEPROM.read(96);
  if (PWM_RIGHT_Slow_EEPROM == 1) {
    PWM_Slow_Speed_RH = EEPROM.read(97); 
    Serial.print(F("PWM Wheel Wire Right value from EEPROM : ")); 
    Serial.println(PWM_Slow_Speed_RH);
  }

  int Slow_Speed_MAG_EEPROM = EEPROM.read(98);
  if (Slow_Speed_MAG_EEPROM == 1) {
    Slow_Speed_MAG = EEPROM.read(99); 
    Slow_Speed_MAG = (Slow_Speed_MAG * -1 ) * 10;
    Serial.print(F("Slow Speed MAG from EEPROM : ")); 
    Serial.println(Slow_Speed_MAG);
  }


  PWM_BLADE_EEPROM = EEPROM.read(17);
  if (PWM_BLADE_EEPROM == 1) {
    PWM_Blade_Speed = EEPROM.read(18); 
    Serial.print(F("PWM Blade value from EEPROM : ")); 
    Serial.println(PWM_Blade_Speed);
  }

  COMPASS_EEPROM = EEPROM.read(19);
  if (COMPASS_EEPROM == 1) {
    Compass_Activate = EEPROM.read(20);  
    Serial.print(F("Compass Settings from EEPROM : "));
    if (Compass_Activate == 0) Serial.println(F("OFF"));
    if (Compass_Activate == 1) Serial.println(F("ON"));
  }
  //Compass_Activate = 0;

 Tracking_PID_P_EEPROM = EEPROM.read(21);
  if (Tracking_PID_P_EEPROM == 1) {
    P = EEPROM.read(22); 
    P = P / 100; 
    Serial.print(F("Traking PID P Setting from EEPROM : "));
    Serial.println(P);
  }


  Pattern_Mow_EEPROM = EEPROM.read(23);
  if (Pattern_Mow_EEPROM == 1) {
    Pattern_Mow = EEPROM.read(24);  
    Serial.print(F("Pattern Mow settings from EEPROM : "));
    if (Pattern_Mow == 0) Serial.println(F("OFF"));
    if (Pattern_Mow == 1) Serial.println(F("ON Parallel"));
    if (Pattern_Mow == 3) Serial.println(F("ON Spiral"));
  }


  Minimum_Volt_EEPROM = (float)EEPROM.read(25);    // flag 0 o 1
  if ((int)Minimum_Volt_EEPROM == 1) {
    int valueRead = 0;                             // qui ci sta 0–32767
    EEPROM.get(100, valueRead);                    // legge due byte da 100–101
    Battery_Min = valueRead / 10.0;                // converti in volt
    Serial.print(F("Minimum Battery Voltage set from EEPROM : "));
    Serial.println(Battery_Min, 1);                // stampa con un decimale
  }



  Compass_Home_EEPROM = EEPROM.read(27);
  if (Compass_Home_EEPROM == 1) {
    Home_Wire_Compass_Heading = (EEPROM.read(28) * 10);    // *10 poiché il valore può essere superiore a 255. Vaule viene quindi memorizzato come decimo valore
    Serial.print(F("Compass Home Degrees : ")); 
    Serial.println(Home_Wire_Compass_Heading);
  }

  Tip_Safety_EEPROM = EEPROM.read(29);
  if (Tip_Safety_EEPROM == 1) {
    Tip_Safety = EEPROM.read(30);  
    Serial.print(F("Pattern Mow settings from EEPROM : "));
    if (Tip_Safety == 0) Serial.println(F("OFF"));
    if (Tip_Safety == 1) Serial.println(F("ON"));
  }


  Mower_Turn_Delay_Min_EEPROM = EEPROM.read(31);
  if (Mower_Turn_Delay_Min_EEPROM == 1) {
    Mower_Turn_Delay_Min = EEPROM.read(32);
    Mower_Turn_Delay_Min = Mower_Turn_Delay_Min * 100;
    Serial.print(F("Mower Turn Delay Min From EEPROM : "));
    Serial.println(Mower_Turn_Delay_Min);
  }

  Mower_Turn_Delay_Max_EEPROM = EEPROM.read(33);
  if (Mower_Turn_Delay_Max_EEPROM == 1) {
    Mower_Turn_Delay_Max = EEPROM.read(34);
    Mower_Turn_Delay_Max =  Mower_Turn_Delay_Max * 100; 
    Serial.print(F("Mower Turn Delay Max From EEPROM : "));
    Serial.println(Mower_Turn_Delay_Max);
  }

  Mower_Reverse_Delay_EEPROM = EEPROM.read(35);
  if (Mower_Reverse_Delay_EEPROM == 1) {
    Mower_Reverse_Delay = EEPROM.read(36);
    Mower_Reverse_Delay = (Mower_Reverse_Delay * 100);
    Serial.print(F("Mower Reverse Time Delay/ms: "));
    Serial.println(Mower_Reverse_Delay);
  }

  Sonar_1_Activate_EEPROM = EEPROM.read(37);
  if (Sonar_1_Activate_EEPROM == 1) {
    Sonar_1_Activate = EEPROM.read(38);
    Serial.print(F("Sonar 1 Activated: "));
    Serial.println(Sonar_1_Activate);
  }

  Sonar_2_Activate_EEPROM = EEPROM.read(39);
  if (Sonar_2_Activate_EEPROM == 1) {
    Sonar_2_Activate = EEPROM.read(40);
    Serial.print(F("Sonar 2 Activated: "));
    Serial.println(Sonar_2_Activate);
  }

  Sonar_3_Activate_EEPROM = EEPROM.read(41);
  if (Sonar_3_Activate_EEPROM == 1) {
    Sonar_3_Activate = EEPROM.read(42);
    Serial.print(F("Sonar 3 Activated: "));
    Serial.println(Sonar_3_Activate);
  }

  Track_Wire_Zone_1_Cycles_EEPROM = EEPROM.read(43);
  if (Track_Wire_Zone_1_Cycles_EEPROM == 1) {
    Track_Wire_Zone_1_Cycles = EEPROM.read(44);
    Track_Wire_Zone_1_Cycles = (Track_Wire_Zone_1_Cycles * 100);
    Serial.print(F("Zone 1 Tracking Cycles "));
    Serial.println(Track_Wire_Zone_1_Cycles);
  }

  Track_Wire_Zone_2_Cycles_EEPROM = EEPROM.read(45);
  if (Track_Wire_Zone_2_Cycles_EEPROM == 1) {
    Track_Wire_Zone_2_Cycles = EEPROM.read(46);
    Track_Wire_Zone_2_Cycles = (Track_Wire_Zone_2_Cycles * 100);
    Serial.print(F("Zone 2 Tracking Cycles "));
    Serial.println(Track_Wire_Zone_2_Cycles);
  }  

  Use_Charging_Station_EEPROM = EEPROM.read(47);
  if (Use_Charging_Station_EEPROM == 1) {
    Compass_Activate = EEPROM.read(48);  
    Serial.print(F("Compass Settings from EEPROM : "));
    if (Compass_Activate == 0) Serial.println(F("OFF"));
    if (Compass_Activate == 1) Serial.println(F("ON"));
  }


  CW_Tracking_To_Charge_EEPROM = EEPROM.read(49);
  if (CW_Tracking_To_Charge_EEPROM == 1) {
    CW_Tracking_To_Charge = EEPROM.read(50);  
    Serial.print(F("Tracking Direction to Charge : "));
    if (CW_Tracking_To_Charge == 1) Serial.println(F("CW"));
    if (CW_Tracking_To_Charge == 0) Serial.println(F("OFF"));
  }

  CCW_Tracking_To_Charge_EEPROM = EEPROM.read(51);
  if (CCW_Tracking_To_Charge_EEPROM == 1) {
    CCW_Tracking_To_Charge = EEPROM.read(52);  
    Serial.print(F("Tracking Direction to Charge : "));
    if (CCW_Tracking_To_Charge == 1) Serial.println(F("CCW"));
    if (CCW_Tracking_To_Charge == 0) Serial.println(F("OFF"));
  }

  CW_Tracking_To_Start_EEPROM = EEPROM.read(53);
  if (CW_Tracking_To_Start_EEPROM == 1) {
    CW_Tracking_To_Start = EEPROM.read(54);  
    Serial.print(F("Tracking Direction to Start : "));
    if (CW_Tracking_To_Start == 1) Serial.println(F("CW"));
    if (CW_Tracking_To_Start == 0) Serial.println(F("OFF"));
  }

  CCW_Tracking_To_Start_EEPROM = EEPROM.read(55);
  if (CCW_Tracking_To_Start_EEPROM == 1) {
    CCW_Tracking_To_Start = EEPROM.read(56);  
    Serial.print(F("Tracking Direction to Start : "));
    if (CCW_Tracking_To_Start == 1) Serial.println(F("CCW"));
    if (CCW_Tracking_To_Start == 0) Serial.println(F("OFF"));
  }

  Max_Cycles_Straight_EEPROM = EEPROM.read(57);
  if (Max_Cycles_Straight_EEPROM == 1) {
    Max_Cycles_Straight = EEPROM.read(58);
    Max_Cycles_Straight = (Max_Cycles_Straight * 10);
    Serial.print(F("Straight Line Cycles before turn: "));
    Serial.println(Max_Cycles_Straight);
  }


  Compass_Heading_Hold_Enabled_EEPROM = EEPROM.read(59);
  if (Compass_Heading_Hold_Enabled_EEPROM == 1) {
    Compass_Heading_Hold_Enabled = EEPROM.read(60);  
    Serial.print(F("Compass HEading Hold Settings from EEPROM : "));
    if (Compass_Heading_Hold_Enabled == 0) Serial.println(F("OFF"));
    if (Compass_Heading_Hold_Enabled == 1) Serial.println(F("ON"));
  }

CPower_EEPROM = EEPROM.read(61);
  if (CPower_EEPROM == 1) {
    CPower = EEPROM.read(62); 
    CPower = CPower / 100; 
    Serial.print(F("Traking PID P Setting from EEPROM : "));
    Serial.println(CPower);
  }

Max_Sonar_Hit_EEPROM = EEPROM.read(63);
  if (Max_Sonar_Hit_EEPROM == 1) {
    Max_Sonar_Hit = EEPROM.read(64); 
    Serial.print(F("Sonar Sensitivoty from EEPROM : "));
    Serial.println(Max_Sonar_Hit);
  }
maxdistancesonar_EEPROM = EEPROM.read(65);
  if (maxdistancesonar_EEPROM == 1) {
    maxdistancesonar = EEPROM.read(66); 
    Serial.print(F("Sonar Activation Distance from EEPROM : "));
    Serial.println(maxdistancesonar);
  }
  
Perimeter_Wire_Enabled_EEPROM = EEPROM.read(67);
  if (Perimeter_Wire_Enabled_EEPROM == 1) {
    Perimeter_Wire_Enabled = EEPROM.read(68);  
    Serial.print(F("Wire Module ON/OFF from EEPROM : "));
    if (Perimeter_Wire_Enabled == 0) Serial.println(F("OFF"));
    if (Perimeter_Wire_Enabled == 1) Serial.println(F("ON"));
  }

  Max_Cycle_Wire_Find_EEPROM = EEPROM.read(69);
  if (Max_Cycle_Wire_Find_EEPROM == 1) {
    Max_Cycle_Wire_Find = EEPROM.read(70);
    Max_Cycle_Wire_Find = (Max_Cycle_Wire_Find * 10);
    Serial.print(F("Track Cycles Forwards to find Wire "));
    Serial.println(Max_Cycle_Wire_Find);
  }

  Max_Cycle_Wire_Find_Back_EEPROM = EEPROM.read(71);
  if (Max_Cycle_Wire_Find_Back_EEPROM == 1) {
    Max_Cycle_Wire_Find_Back = EEPROM.read(72);
    Max_Cycle_Wire_Find_Back = (Max_Cycle_Wire_Find_Back * 10);
    Serial.print(F("Track Cycles Back to find Wire "));
    Serial.println(Max_Cycle_Wire_Find_Back);
  }
  
  Max_Tracking_Turn_Right_EEPROM = EEPROM.read(73);
  if (Max_Tracking_Turn_Right_EEPROM == 1) {
    Max_Tracking_Turn_Right = EEPROM.read(74);
    Max_Tracking_Turn_Right = (Max_Tracking_Turn_Right * 10);
    Serial.print(F("Wheel RH Cycles before restart "));
    Serial.println(Max_Tracking_Turn_Right);
  }

  Max_Tracking_Turn_Left_EEPROM = EEPROM.read(75);
  if (Max_Tracking_Turn_Left_EEPROM == 1) {
    Max_Tracking_Turn_Left = EEPROM.read(76);
    Max_Tracking_Turn_Left = (Max_Tracking_Turn_Left * 10);
    Serial.print(F("Wheel LH Cycles before restart "));
    Serial.println(Max_Tracking_Turn_Left);
  }

Rain_Sensor_Installed_EEPROM = EEPROM.read(77);
  if (Rain_Sensor_Installed_EEPROM == 1) {
    Rain_Sensor_Installed = EEPROM.read(78);  
    Serial.print(F("Rain Sensor ON/OFF from EEPROM : "));
    if (Rain_Sensor_Installed == 0) Serial.println(F("OFF"));
    if (Rain_Sensor_Installed == 1) Serial.println(F("ON"));
  }

Rain_Total_Hits_Go_Home_EEPROM = EEPROM.read(79);
  if (Rain_Total_Hits_Go_Home_EEPROM == 1) {
    Rain_Total_Hits_Go_Home = EEPROM.read(80); 
    Serial.print(F("Rain Sensitivoty from EEPROM : "));
    Serial.println(Rain_Total_Hits_Go_Home);
  }

WIFI_Enabled_EEPROM = EEPROM.read(81);
  if (WIFI_Enabled_EEPROM == 1) {
    WIFI_Enabled = EEPROM.read(82);  
    Serial.print(F("WIFI Enabled from EEPROM : "));
    if (WIFI_Enabled == 0) Serial.println(F("OFF"));
    if (WIFI_Enabled == 1) Serial.println(F("ON"));
  }

Cutting_Blades_Activate_EEPROM = EEPROM.read(83);
  if (Cutting_Blades_Activate_EEPROM == 1) {
    Cutting_Blades_Activate = EEPROM.read(84);  
    Serial.print(F("CUTTING BLADES SET TO : "));
    if (Cutting_Blades_Activate == 0) Serial.println(F("OFF"));
    if (Cutting_Blades_Activate == 1) Serial.println(F("ON"));
  }


Low_Battery_Instances_Chg_EEPROM = EEPROM.read(85);
  if (Low_Battery_Instances_Chg_EEPROM == 1) {
    Low_Battery_Instances_Chg = EEPROM.read(86); 
    Serial.print(F("Battery to Charge Sensitivoty from EEPROM : "));
    Serial.println(Low_Battery_Instances_Chg);
  }


Bumper_Activate_Frnt_EEPROM = EEPROM.read(90);
  if (Bumper_Activate_Frnt_EEPROM == 1) {
    Bumper_Activate_Frnt = EEPROM.read(91);  
    Serial.print(F("Bumper Bar Enabled from EEPROM : "));
    if (Bumper_Activate_Frnt == 0) Serial.println(F("OFF"));
    if (Bumper_Activate_Frnt == 1) Serial.println(F("ON"));
  }


  Wheel_Amp_Sensor_ON_EEPROM = EEPROM.read(115);
  if (Wheel_Amp_Sensor_ON_EEPROM == 1) {
    Wheel_Amp_Sensor_ON = EEPROM.read(116);  
    Serial.print(F("Wheel Block Amp Sensor Enabled from EEPROM : "));
    if (Wheel_Amp_Sensor_ON == 0) Serial.println(F("Disabled"));
    if (Wheel_Amp_Sensor_ON == 1) Serial.println(F("Enabled"));
  }
  
  Max_Wheel_Amps_EEPROM = EEPROM.read(117);
  if (Max_Wheel_Amps_EEPROM == 1) {
    Max_Wheel_Amps = EEPROM.read(118); 
    Max_Wheel_Amps = Max_Wheel_Amps / 10; 
    Serial.print(F("Wheel Block Amps set from EEPROM : "));
    Serial.println(Max_Wheel_Amps);
  }

  Track_Wire_Zone_3_Cycles_EEPROM = EEPROM.read(119);
  if (Track_Wire_Zone_3_Cycles_EEPROM == 1) {
    Track_Wire_Zone_3_Cycles = EEPROM.read(120);
    Track_Wire_Zone_3_Cycles = (Track_Wire_Zone_3_Cycles * 100);
    Serial.print(F("Zone 3 Tracking Cycles "));
    Serial.println(Track_Wire_Zone_3_Cycles);
  }


  Cycles_Max_EEPROM = EEPROM.read(123);
  if (Cycles_Max_EEPROM == 1) {
    Cycles_Max = EEPROM.read(124);
    Cycles_Max = (Cycles_Max * 100);
    Serial.print(F("Cycles_Max "));
    Serial.println(Cycles_Max);
  }

  if (Boost_Turn == 1){
    Serial.println(F("Setting: Boost Turn Activated"));
    Serial.print(F("Min Track PWM = "));
    Serial.println(Min_Track_PWM);
    Serial.print(F("Boost Time = "));
    Serial.println(Hard_Track_Turn_Delay);
  }
  

    PWM_LEFT_EEPROM = EEPROM.read(125);
  if (PWM_LEFT_EEPROM == 1) {
    PWM_MaxSpeed_LH = EEPROM.read(126);
    Serial.print(F("PWM Wheel Left value from EEPROM : "));
    Serial.println(PWM_MaxSpeed_LH);
  }

  PWM_RIGHT_EEPROM = EEPROM.read(127);
  if (PWM_RIGHT_EEPROM == 1) {
    PWM_MaxSpeed_RH = EEPROM.read(128); 
    Serial.print(F("PWM Wheel Right value from EEPROM : ")); 
    Serial.println(PWM_MaxSpeed_RH);
  }
  if (Boost_Turn == 0) Serial.print(F("Setting: Boost Turn OFF"));

  Serial.println(F(""));

  RPLIDAR_Enabled_EEPROM = EEPROM.read(159);
  if (RPLIDAR_Enabled_EEPROM == 1) {
    RPLIDAR_Enabled = EEPROM.read(160);  
    Serial.print(F("RPLidar Module ON/OFF from EEPROM : "));
    if (RPLIDAR_Enabled == 0) Serial.println(F("OFF"));
    if (RPLIDAR_Enabled == 1) Serial.println(F("ON"));
  }

  maxdistanceLIDAR_EEPROM = EEPROM.read(161);
  if (maxdistanceLIDAR_EEPROM == 1) {
    maxdistanceLIDAR = EEPROM.read(162); 
    Serial.print(F("Lidar Activation Distance from EEPROM : "));
    Serial.println(maxdistanceLIDAR);
  }

  GYRO_Enabled_EEPROM = EEPROM.read(163);
  if (GYRO_Enabled_EEPROM == 1) {
    GYRO_Enabled = EEPROM.read(164);  
    Serial.print(F("GYRO Enabled from EEPROM : "));
    if (GYRO_Enabled == 0) Serial.println(F("Disabled"));
    if (GYRO_Enabled == 1) Serial.println(F("Enabled"));
  }

  Kp_EEPROM = EEPROM.read(171);
  if (Kp_EEPROM == 1) {
    Kp = EEPROM.read(170);  // Mantieni in centesimi
    Serial.print(F("Kp PID Setting from EEPROM (centesimi): "));
    Serial.println(Kp);
  }

  Ki_EEPROM = EEPROM.read(173);
  if (Ki_EEPROM == 1) {
    Ki = EEPROM.read(172);
    Serial.print(F("Ki PID Setting from EEPROM (centesimi): "));
    Serial.println(Ki);
  }

  Kd_EEPROM = EEPROM.read(175);
  if (Kd_EEPROM == 1) {
    Kd = EEPROM.read(174);
    Serial.print(F("Kd PID Setting from EEPROM (centesimi): "));
    Serial.println(Kd);
  }

  Tracking_PID_P_Return_EEPROM = EEPROM.read(177);
  if (Tracking_PID_P_Return_EEPROM == 1) {
    P_Return = EEPROM.read(176); 
    P_Return = P_Return / 100; 
    Serial.print(F("Traking PID P Return Setting from EEPROM : "));
    Serial.println(P_Return);
  }


Serial.println(F("*************************"));
 delay(500);

}


void Clear_EERPOM() {
  EEPROM.write(1,0);      // Cancella allarme 1
  EEPROM.write(5,0);      // Cancella allarme 2
  EEPROM.write(9,0);      // Cancella allarme 3
  EEPROM.write(13,0);     // Cancella PWM ruota sinistra
  EEPROM.write(15,0);     // Cancella PWM ruota desstra
  EEPROM.write(17,0);     // Cancella PWM Lama
  EEPROM.write(19,0);     // Cancella impostazione bussola EEPROM
  EEPROM.write(21,0);     // Cancella impostazione PID
  EEPROM.write(23,0);     // Cancella schema di taglio
  EEPROM.write(25,0);     // Cancella Volt Minimi
  EEPROM.write(27,0);     // Cancella Bussola Home
  EEPROM.write(29,0);     // Cancella Tip Safety
  EEPROM.write(31,0);     // Cancella Tempo di svolta minimo
  EEPROM.write(33,0);     // Cancella Tempo di svolta massimo
  EEPROM.write(35,0);     // Cancella Tempo di inversione
  EEPROM.write(37,0);     // Cancella Sonar 1
  EEPROM.write(39,0);     // Cancella Sonar 2
  EEPROM.write(41,0);     // Cancella Sonar 3
  EEPROM.write(43,0);     // Cancella Zone 1 Cycles
  EEPROM.write(45,0);     // Cancella Zone 2 Cycles
  EEPROM.write(120,0);    // Cancella Zone 3 Cycles
  EEPROM.write(47,0);     // Cancella opzioni stazione di ricarica
  EEPROM.write(49,0);     // Reimposta le direzioni di uscita e attracco in senso orario e antiorario
  EEPROM.write(51,0);     // Cancella Tracciatura CW CCW
  EEPROM.write(53,0);     // Cancella Tracciatura CW CCW
  EEPROM.write(55,0);     // Cancella Tracciatura CW CCW
  EEPROM.write(57,0);     // Cancella Max Cycle Straight
  EEPROM.write(59,0);     // Cancellare Direzione bussola ON/OFF
  EEPROM.write(61,0);     // Reset PID Bussola.
  EEPROM.write(63,0);     // Cancella sensibilità Sonar.
  EEPROM.write(65,0);     // Resetta la massima distanza sonar.
  EEPROM.write(67,0);     // Cancella sensore filo ON/OFF
  EEPROM.write(69,0);     // Cancella Track cycles Avanti
  EEPROM.write(71,0);     // Cancella Track Cycles Indierto
  EEPROM.write(73,0);     // RH Cycles to restart
  EEPROM.write(75,0);     // LH Cycles to restart
  EEPROM.write(77,0);     // Cancella sensore pioggia ON/OFF
  EEPROM.write(79,0);     // Cancella sensibilità sensore pioggia
  EEPROM.write(81,0);     // Cancella WIFI ON/OFF
  EEPROM.write(83,0);     // Cancella attivazione lama ON/OFF
  EEPROM.write(85,0);     // Cancella sensibilità batteria;
  EEPROM.write(87,0);     // Alarm Actions 1
  EEPROM.write(88,0);     // Alarm Actions 2
  EEPROM.write(89,0);     // Alarm Actions 3
  EEPROM.write(90,0);     // Cancella Paraurti anteriore
  EEPROM.write(94,0);     // Cancella velocità Wheel Slow Speed LH
  EEPROM.write(96,0);     // Cancella velocità Wheel Slow Speed RH
  EEPROM.write(98,0);     // Cancella Slow MAG Point
  EEPROM.write(115,0);    // Cancella attivazione sensore amperaggio motori 
  EEPROM.write(117,0);    // Cancella valore sensore amperaggio motori
  EEPROM.write(123,0);    // Cancella Cycles Max
  EEPROM.write(125,0);    // Cancella il PWM della tracciatura filo perimetrale ruota SX
  EEPROM.write(127,0);    // Cancella il PWM della tracciatura filo perimetrale ruota DX
  EEPROM.write(130,0);    // Cancella Alarm 4
  EEPROM.write(135,0);    // Cancella Alarm 5
  EEPROM.write(140,0);    // Cancella Alarm 6
  EEPROM.write(134,0);    // Alarm Actions 4
  EEPROM.write(139,0);    // Alarm Actions 5
  EEPROM.write(144,0);    // Alarm Actions 6
  EEPROM.write(159,0);    // Cancella sensore RPLidar ON/OFF
  EEPROM.write(161,0);    // Resetta la massima distanza del Lidar.
  EEPROM.write(163,0);    // Cancella Gyro ON/OFF
  EEPROM.write(171, 0);   // Resetta Kp
  EEPROM.write(173, 0);   // Resetta Ki
  EEPROM.write(175, 0);   // Resetta Kd
  EEPROM.write(177,0);    // Cancella impostazione PID Return
  EEPROM.write(100, 0);     // azzera parte bassa Battery_Min (int decimi)
  EEPROM.write(101, 0);     // azzera parte alta Battery_Min


  
  Serial.println(F("All EEPROM Settings Cleared"));
  delay(1000);
  
}
