Marcobedendo78/Robot-Arduino-4.0/(commit log)

2025-05-24 Aggiornato il codice del nodeMCU8266 per comunicare con Home Assistant e aggiornato il codice di Arduino mega per la parte del wifi e aggiunto il controllo di mantenimento della direzione tramite PID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
2025-05-31 Aggiunto sketch per il NODEMCU8266 MQTT
    Aggiunto auto discovery per la parte MQTT.
2025-06-02 Corretto alcuni problemi con i comandi ricevuti da Home assistant e aggiunto il controllo di direzione con gyro e aggiunto le funzioni del Lidar. Questo ancora in fase sperimentale
    [Amperaggio_e_Voltaggio.ino, Applicazione_Setup.ino, Configurazione_Motori.ino, EEPROM.ino, Manovre.ino, Menu_Sensori.ino, Tracciatura_Filo_Perimetrale.ino]
2025-06-02 Aggiunto README con immagini e guida assemblaggio
2025-06-02 Update README_PCB.md
    Aggiunto README con immagini e guida assemblaggio
2025-06-03 Corretto un bug con un sonar e aggiornato il reso del codice
    [Manovre.ino, Tracciatura_Filo_Perimetrale.ino]
2025-06-03 Corretto Sensori Ultrasuoni
2025-06-05 Modificato la funzione di manovra con i sonar
2025-06-07 Aggiunto in configurazione motori una nuova rampa di accelerazione per i motori usata nella manovre. Ora la rampa funziona così accelera-crociera-decelera per evitare movimenti bruschi. Aggiornare i 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
2025-06-11 Modificato lo sketch per il filo perimetrale inserendo la possibilità di sceltra tra i driver L298 o i BTS7960
2025-07-12 Modificato la logica di rotazione con la bussola e migliorato il mantenimento di corsia con l'accelerometro rendendolo meno pesante per ardino mega
2025-07-22 Sistemato bug con il gyro se si faceva partire il robot manualmente, ora salva la direzione corretta e la mantiene
    [Manovre.ino]
2025-08-06 In questa versione sono presenti molte modifiche sul controllo del robot. Aggiunto la possibilità di scelta del motore da taglio se brushless o brushed, regolato tutte le manovre con rampe di acceler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
2025-08-10 Corretto nel mantenimento di direzione tramite giroscopio l'utilizzo del PWM settattoto da pannello LCD al posto di un valore fisso.
2025-08-10 Aggiunto istruzioni per il montaggio dei pezzi per la modifica al motore
2025-08-19 Update aggiornamento_robot_brushless.md
    Corretto il collegamento dei pin del driver al PCB.
2025-08-19 Corretto i nomi dei pin della lama corrispondenti sul PCB
2025-08-23 Aggiunto gli sketch delle varie schede aggiornati con la modifica per poter essere usati con una lipo 8s massima. Aggiunto anche la tracciatura del filo perimetrale con l'utilizzo di 2 sensori e ramp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
2025-08-23 Modificato il tipo di batterie utilizzabili. Massimo lipo 8s. Aggiunto anche rampa di accelerazione dopo ogni manovra e tracciature del filo perimetrale con doppio sensore.
2025-08-23 Sketch modificato per l'utilizzo di una batteria lipo 8s massima, doppio sensore filo perimetrale e arampa di accelerazione dopo ogni manovra
2025-08-24 Corretto il sensore di voltaggio, ora trasmette anche il valore con la virgola
2025-08-24 Corretto il sensore voltaggio. ora trasmette i numeri con la virgola
2025-08-27 Corretto il problema con il salvataggio della tensione minima per la ricarica ora il valore viene salvato correttamente in eeprom
    [Amperaggio_e_Voltaggio.ino, Configurazione_Motori.ino, EEPROM.ino, MEGA_V1_8.ino, Menu_Sensori.ino]
2025-09-02 Corretto bug con l'accelerometro. Se si fermava il robot e lo si spostava alla ripartenza non ricalibrava l'accelerometro
    [Manovre.ino]
2025-09-04 Aggiunto il controllo del paraurti anche nella tracciatura del ritorno in base
