Marcobedendo78/Robot-Arduino-4.0/Mod_brushless_motor/20250805_154742.jpg

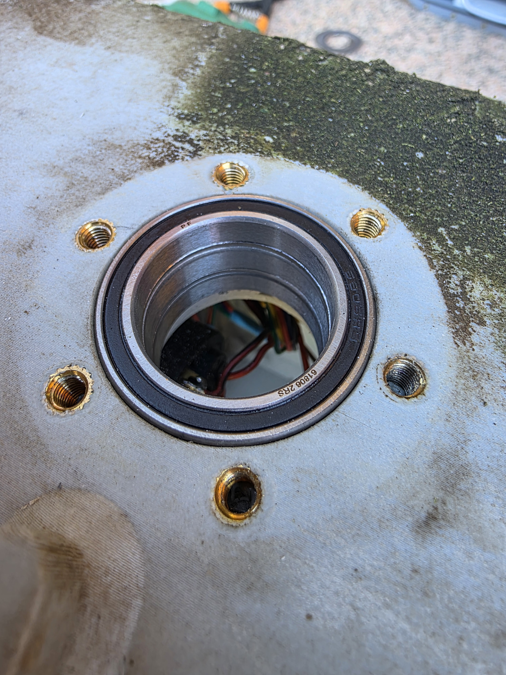
[picture p4: Mod_brushless_motor/20250805_154742.jpg]
Mod_brushless_motor/20250805_154742.jpg
