Marcobedendo78/Robot-Arduino-4.0/Mod_brushless_motor/20250805_155114.jpg

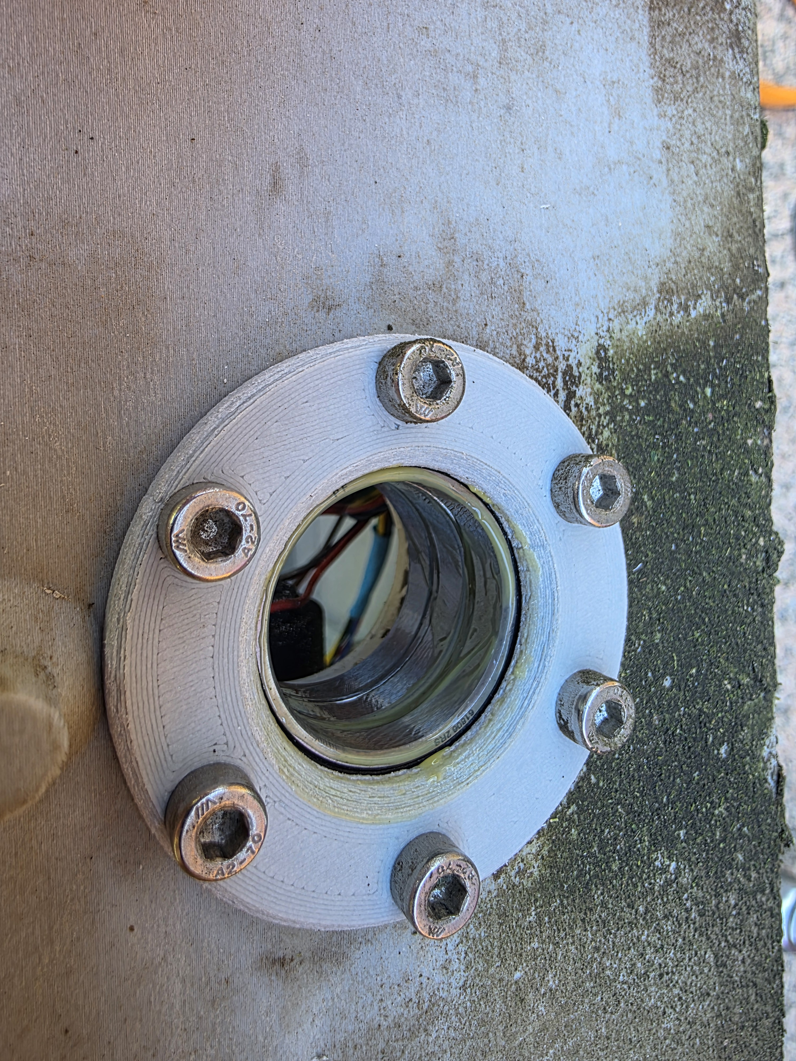
[picture p6: Mod_brushless_motor/20250805_155114.jpg]
Mod_brushless_motor/20250805_155114.jpg
