Marcobedendo78/Robot-Arduino-4.0/Mod_brushless_motor/20250805_203757.jpg

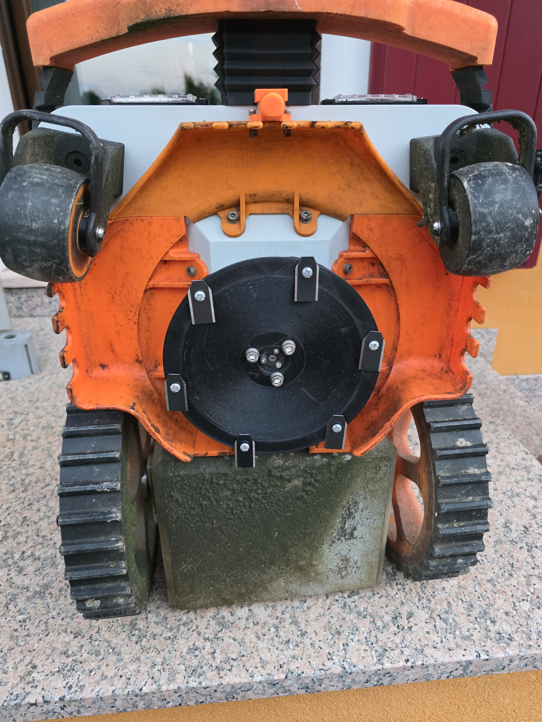
[picture p17: Mod_brushless_motor/20250805_203757.jpg]
Mod_brushless_motor/20250805_203757.jpg
