Marcobedendo78/Robot-Arduino-4.0/Mod_brushless_motor/20250806_175828.jpg

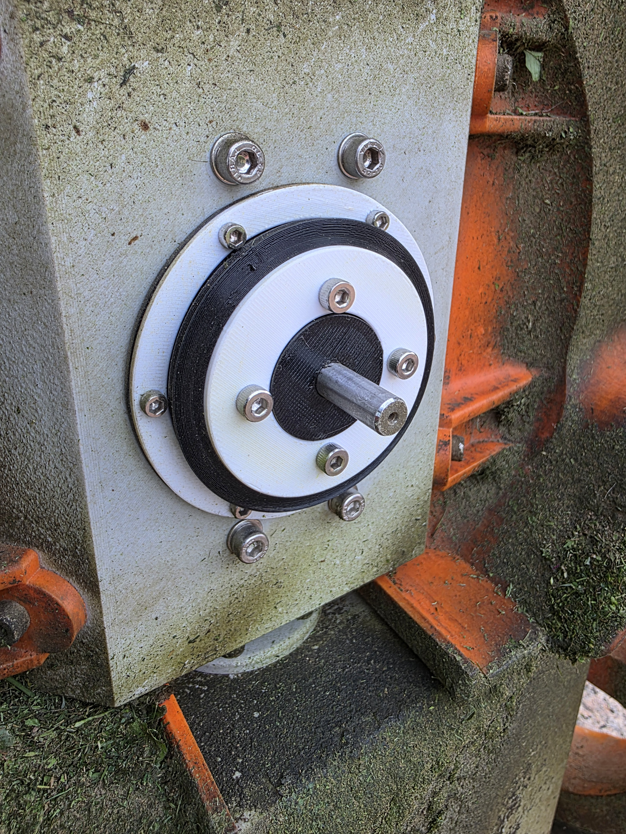
[picture p18: Mod_brushless_motor/20250806_175828.jpg]
Mod_brushless_motor/20250806_175828.jpg
