Marcobedendo78/Robot-Arduino-4.0/Img/20250508_174329.jpg

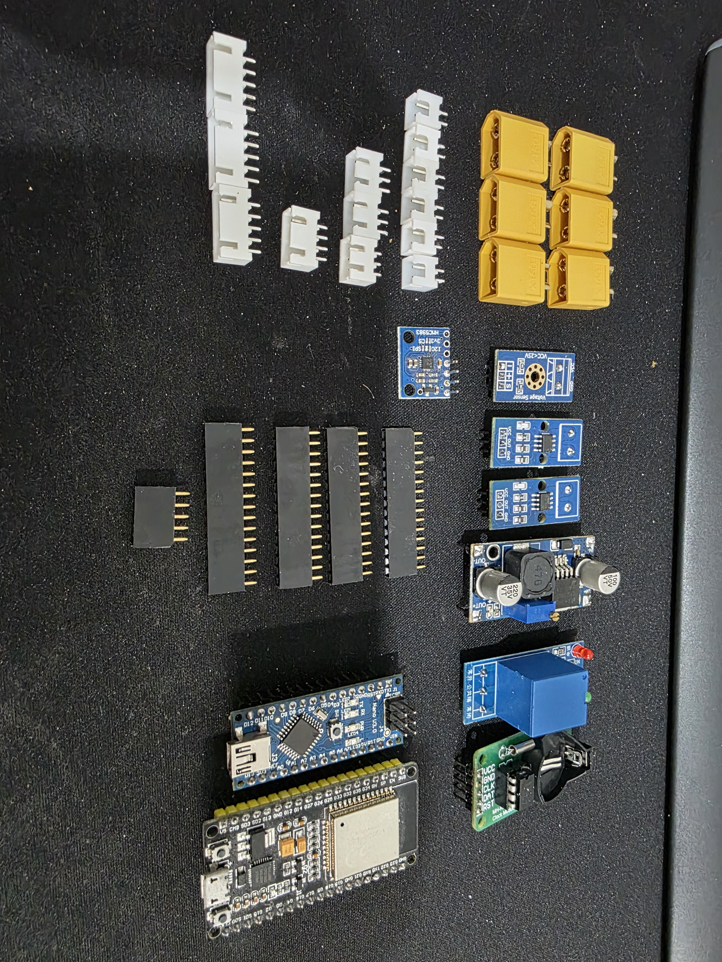
[picture p19: Img/20250508_174329.jpg]
Img/20250508_174329.jpg
